samuelwilliams413/METR4810/Software/Demo75_with_interupts/Demo75/keys.pdf

q | Winch up a | Winch down w | Servo 1 + 10° s | Servo 1 - 10° e | Servo 2 + 10° d | Servo 2 - 10° i | Car forward k | Stop car l | Turn right j | Turn left m | Reverse

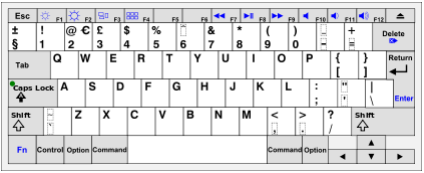
[picture p1: figure]
