samuelwilliams413/METR4810/Software/keys.pdf

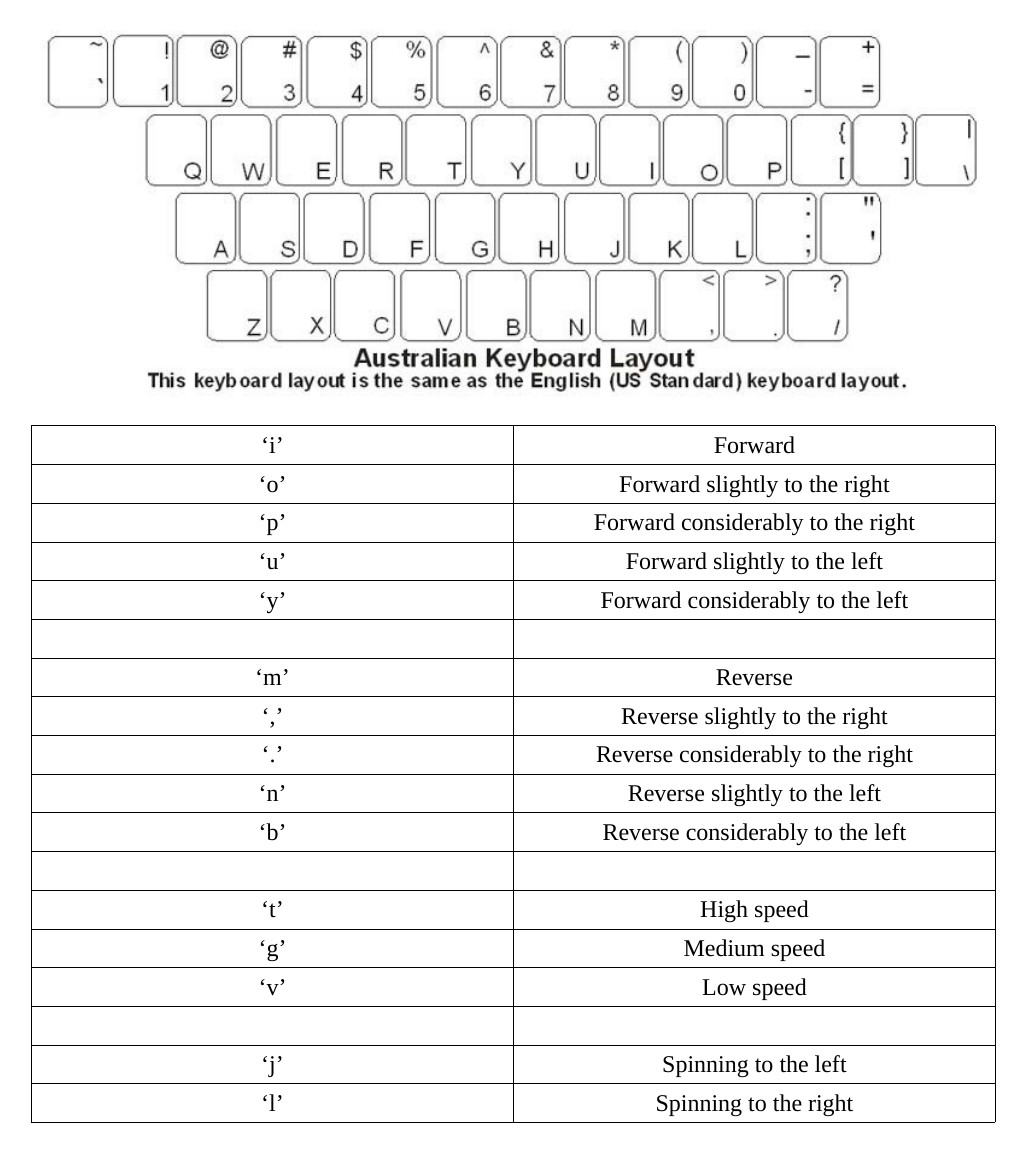
[picture p2: figure]

K stop
