samuelwilliams413/METR4810/Bill of Materials/Sam_BOM_Part List.xlsx

Sheet: Sheet1
Component Names | Description | Part Number | Quantity Used | Supplier | Unit Cost (ex GST) | Preowned | Datasheet Provided | Cost | Sum Total
Central Controller PCB |  |  |  |  |  |  |  | 15.5629 | 37.70757333
Atmega324 | Atmega324 | Atmega324-AU-1322 | 1 | Mouser | 4.06 | Yes | Yes | 4.06 | https://www.digikey.com/product-detail/en/microchip-technology/ATMEGA324P-20AUR/ATMEGA324P-20AURCT-ND/3440935
10K Ohm Resistor | 10K Ohm Resistor |  | 1 | Digikey | 0.00148 | No | Yes | 0.00148 | https://www.digikey.com/product-detail/en/yageo/RC0402JR-0710KP/YAG1281TR-ND/4935296
1K Ohm Resistor | 1K Ohm Resistor |  | 9 | Digikey | 0.00106 | No | Yes | 0.00954 | https://www.digikey.com/product-detail/en/yageo/RC0402JR-071KL/311-1.0KJRTR-ND/726408
1uF Capacitor | 1uF Capacitor |  | 4 | Jameco | 0.023 | No | Yes | 0.092 | http://www.jameco.com/z/12063G105ZAT2A-AVX-Capacitor-1-uF-25-Volt-Y5-Volt-20-To-80-Surface-Mount-1206-Embossed-Tape-and-Reel_740324.html
100pF Capacitor | 100pF Capacitor |  | 5 | Jameco | 0.005 | No | Yes | 0.025 | http://www.jameco.com/z/GRM1885C1H101JA01J-Murata-Capacitor-100pf-50-Volt-C0G-5-Surface-Mount-0603-Paper-Tape-and-Reel_1856644.html
L7805CD2T Volateg Regulator | Positive voltage regulator IC | L7805CD2T | 1 | Mouser | 0.321 | No | Yes | 0.321 | http://au.mouser.com/ProductDetail/STMicroelectronics/L7805CD2T-TR/
L293D Motor Driver | Push-pull four channel driver with diodes | L293D | 1 | Digikey | 2.84 | Yes | Yes | 2.84 | https://www.digikey.com.au/product-detail/en/stmicroelectronics/L293D/497-2936-5-ND/634700
16 Pin Socket | 16 Pin Socket |  | 1 | Jameco | 0.39 | Yes | No | 0.39 | http://www.jameco.com/z/6100-16-R-Socket-IC-16-Pin-Machine-Tooled-Low-Profile-0-3-Inch-Wide_37402.html
2 Pin Header | KK Style - Straight Header Male |  | 2 | Element14 | 0.113 | No | Yes | 0.226 | http://au.element14.com/molex/22-27-2021/header-square-pin-2-54mm-2way/dp/9731148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
2 Pin Header | KK Style - Straight Header Female |  | 2 | Element14 | 0.031 | No | Yes | 0.062 | http://au.element14.com/molex/22-01-3027/housing-square-pin-2-54mm-2way/dp/1462825?ost=22-01-3027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
3 Pin Header | KK Style - Straight Header Male |  | 3 | Element14 | 0.296 | No | Yes | 0.888 | http://au.element14.com/molex/22-27-2031/header-square-pin-2-54mm-3way/dp/9731156
3 Pin Header | KK Style - Straight Header Female |  | 3 | Element14 | 0.099 | No | Yes | 0.297 | http://au.element14.com/molex/22-01-3037/housing-female-3way/dp/1462838?ost=22-01-3037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
4 Pin Header | KK Style - Straight Header Male |  | 4 | Element14 | 0.408 | No | Yes | 1.632 | http://au.element14.com/molex/22-27-2041/header-square-pin-2-54mm-4way/dp/9731164?ost=22-27-2041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
4 Pin Header | KK Style - Straight Header Female |  | 4 | Element14 | 0.139 | No | Yes | 0.556 | http://au.element14.com/molex/22-01-3047/housing-female-4way/dp/1462831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
Crimp | KK Style Crimp |  | 29 | Element14 | 0.027 | No | Yes | 0.783 | http://au.element14.com/molex/08-50-0113/contact-crimp-terminal-30-22awg/dp/2063734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
2x3 Pin Header | 6 Way 2 Row Header |  | 1 | modDIY | $0.59 | No | Yes | 0.59 | https://www.moddiy.com/products/0.100%22-%282.54-mm%29-Breakaway-Male-Header%3A-2x40%252dPin%2C-Straight.html
DB15 Female Header | DB15 Female Header |  | 1 | Digikey | 0.81788 | No | No | 0.81788 | https://www.digikey.com/product-detail/en/amphenol-fci/10090926-P154XLF/609-4022-ND/2350294
Diode | 0603 Series Blue LED | 697-3617 | 4 | RS | $0.24 | No | Yes | 0.972 | http://au.rs-online.com/web/p/visible-leds/6973617/?searchTerm=697-3617
PCB | 55mm x 60mm x 1.6mm 2 layer PCB |  | 1 | PCBway | 1 | No | No | 1
Distribution PCB |  |  |  |  |  |  |  | 6.83306
1K Ohm Resistor | 1K Ohm Resistor |  | 3 | Digikey | 0.00106 | No | Yes | 0.00318 | https://www.digikey.com/product-detail/en/yageo/RC0402JR-071KL/311-1.0KJRTR-ND/726408
1uF Capacitor | 1uF Capacitor |  | 2 | Jameco | 0.023 | No | Yes | 0.046 | http://www.jameco.com/z/12063G105ZAT2A-AVX-Capacitor-1-uF-25-Volt-Y5-Volt-20-To-80-Surface-Mount-1206-Embossed-Tape-and-Reel_740324.html
100pF Capacitor | 100pF Capacitor |  | 4 | Jameco | 0.005 | No | Yes | 0.02 | http://www.jameco.com/z/GRM1885C1H101JA01J-Murata-Capacitor-100pf-50-Volt-C0G-5-Surface-Mount-0603-Paper-Tape-and-Reel_1856644.html
3 Pin Header | KK Style - Straight Header Male |  | 3 | Element14 | 0.296 | No | Yes | 0.888 | http://au.element14.com/molex/22-27-2031/header-square-pin-2-54mm-3way/dp/9731156
3 Pin Header | KK Style - Straight Header Female |  | 3 | Element14 | 0.099 | No | Yes | 0.297 | http://au.element14.com/molex/22-01-3037/housing-female-3way/dp/1462838?ost=22-01-3037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
4 Pin Header | KK Style - Straight Header Male |  | 5 | Element14 | 0.408 | No | Yes | 2.04 | http://au.element14.com/molex/22-27-2041/header-square-pin-2-54mm-4way/dp/9731164?ost=22-27-2041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
4 Pin Header | KK Style - Straight Header Female |  | 5 | Element14 | 0.139 | No | Yes | 0.695 | http://au.element14.com/molex/22-01-3047/housing-female-4way/dp/1462831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
Crimp | KK Style Crimp |  | 29 | Element14 | 0.027 | No | Yes | 0.783 | http://au.element14.com/molex/08-50-0113/contact-crimp-terminal-30-22awg/dp/2063734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
DB15 Female Header | DB15 Female Header |  | 1 | Digikey | 0.81788 | No | No | 0.81788 | https://www.digikey.com/product-detail/en/amphenol-fci/10090926-P154XLF/609-4022-ND/2350294
Diode | 0603 Series Blue LED | 697-3617 | 1 | RS | $0.24 | No | Yes | 0.243 | http://au.rs-online.com/web/p/visible-leds/6973617/?searchTerm=697-3617
PCB | 38mm x 45mm x 1.6mm 2 layer PCB |  | 1 | PCBway | 1 | No | No | 1
Miscellaneous |  |  |  |  |  |  |  | 7.97828
15 Core Unscreened PVC Cable | 15 Core Unscreened PVC Cable |  | 2 | RS | 2.372 | No | Yes | 4.744 | http://au.rs-online.com/web/p/multicore-industrial-cable/6603999/
Motor Driver |  |  | 1 |  |  | Yes | Yes | 0
Buck |  |  | 1 |  |  | No | Yes | 0
HC-05 |  |  | 1 |  |  | No | Yes | 0
Rocker Switch, Non Illuminated | Rocker Switch, Non Illuminated | A8L-11-15N1 | 1 |  | 1.52 | No | Yes | 1.52 | http://au.element14.com/omron-electronic-components/a8l-11-15n1/switch-rocker-spst-mini/dp/1829494?mckv=s|pcrid|59148083448&gross_price=true&CATCI=aud-112905144048:pla-173777534688&CAAGID=12550800888&CMP=KNC-GOO-SHOPPING-1829494&CAGPSPN=pla&gclid=CMW-5P6GkdQCFUd9vQodM9wPcA&CAWELAID=120185580000129312
Battery Pack |  |  |  |  |  | No | No | 0
DB15 Male Header | DB15 Male Header |  | 2 | Digikey | 0.51214 | No | Yes | 1.02428 | https://www.digikey.com/product-detail/en/amphenol-fci/10090769-P154ALF/609-4042-ND/2350290
DB15 Backshell | DB15 Backshell |  | 2 | Digikey | 0.345 | No | Yes | 0.69 | https://www.digikey.com/product-detail/en/cinch-connectivity-solutions-aim-cambridge/40-9709H/367-1139-ND/3830261
Buoy |  |  |  |  |  |  |  | 7.333333333
Bolts |  |  |  |  |  |  |  | 0
Nuts |  |  |  |  |  |  |  | 0
EVA Foam Tiles | EVA Foam Tiles |  | 0.4 | Kmart | 10 | No | No | 4 | http://www.kmart.com.au/product/eva-solid-floor-tiles/764887
25m PVC Pipe |  |  |  |  |  |  |  | 0
25m PVC Pipe Elbow Connector |  |  |  |  |  |  |  | 0
Food Containers | Food Containers |  | 2 | Woolworths | 1.666666667 | Yes | No | 3.333333333
Spiral Binding |  |  |  |  |  |  |  | 0
25 mm Saddles

Sheet: Sheet2
10K Ohm Resistor | 10K Ohm Resistor |  | 1 | 4 | ETSG
1K Ohm Resistor | 1K Ohm Resistor |  | 12 | 48 | ETSG
1uF Capacitor | 1uF Capacitor |  | 6 | 24 | ETSG
100pF Capacitor | 100pF Capacitor |  | 9 | 36 | ETSG
16 Pin Socket | 16 Pin Socket |  | 1 | 4 | ETSG
2 Pin Header | KK Style - Straight Header |  | 2 | 8 | ETSG
3 Pin Header | KK Style - Straight Header |  | 6 | 24 | ETSG
4 Pin Header | KK Style - Straight Header |  | 9 | 36 | ETSG
2x3 Pin Header | 6 Way 2 Row Header |  | 1 | 4 | ETSG
Atmega324 | Atmega324 | Atmega324-AU-1322 | 1 | 4 | RS
L7805C2T Volateg Regulator | Positive voltage regulator IC | L7805C2T | 1 | 4 | RS
L293D Motor Driver | Push-pull four channel driver with diodes | L293D | 1 | 4 | RS
DB15 Female Header | DB15 Female Header |  | 2 | 8 | RS
Diode | 0603 Series Blue LED | 697-3617 | 5 | 20 | RS
DB15 Cable MM |  |  | 1 | 4 | RS
Motor Driver |  |  | 1 | 4 | RS
Buck |  |  | 1 | 4 | RS
HC-05 |  |  | 1 | 4 | RS
