samuelwilliams413/METR4810/Bill of Materials/BillOfMaterialsMcKay.xlsx

Bill Of Materials
Item | Qty | Price /unit | Total Cost | Purchase Location
12V Micro Gear Motor | 4 | 3.59 (5% discount) | 0 | http://www.ebay.com.au/itm/DC-12V-100RPM-Gearbox-Mini-Metal-Gear-geared-Motor-Gearwheel-N20-Shaft-Dia-3mm-/391722197482
Micro Metal Gear Motor Mounts | 0 | 3.87 | 0 | https://www.pololu.com/product/989
65mm Off Road Tires | 1 | 6.9 | 6.9 | http://www.kmart.com.au/webapp/wcs/stores/servlet/ProductDisplay?urlRequestType=Base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
Aluminium Sheet | 33000 | 6.655902778e-05 | 2.196447917 | http://earlybirdsteel.com.au/aluminium/aluminium-sheet
3D Printed Pieces | 4 | 0 | 0
Romak Hexagon Nuts | 0 | 0.135 | 0 | Romak hexagon nuts M3 24 pack
Romak M3 Bolts | 0 | 0.165 | 0 | Romak M3x15mm bolts 20 pack
L298N Motor Drivers | 3 | 1.87 | 5.61 | http://www.ebay.com/itm/Stepper-Motor-Drive-Controller-Board-Module-L298N-Dual-H-Bridge-DC-For-Arduino-M-/172390155575
Eiger 40Lumen Torches | 0 | 3.666666667 | 0
Waterproof LED strip | 6 | 0.0824 | 0.4944 | http://www.ebay.com.au/itm/24-48-96-120-LED-Car-Flexible-Linear-Strip-Light-Fish-Tank-Aquarium-Waterproof-/302250643921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
 |  |  |  | http://www.ebay.com/itm/DC12V-16ft-1-5M-5630-waterproof-300-LED-Light-Strip-Flexible-Ribbon-3M-Tape-lamp-/262373742486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
3mm Hex Wheel Adaptor | 2 | 2.99 | 5.98
12V 9.8kg/cm torque micro motors | 4 | 8.86 | 35.44 | http://www.ebay.com/itm/1Pcs-DC6V-12V-N20-Micro-Gear-Motor-Gear-Ratio-1-1000-High-Torque-10-15-20-30rpm-/172438281294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
30A VNH2SP30 motor driver | 1 | 7.29 | 0 | http://www.ebay.com/itm/1pcs-Dual-VNH2SP30-Stepper-Motor-Driver-Module-Monster-Moto-Shield-Replace-L298N-/201414927724
12V 25D 300 oz-in motor | 4 | 9 | 0 | http://www.ebay.com/itm/1PCS-DC12V-80RPM-CNDF-Gear-Box-Motor-with-Diameter-25mm-Metal-Gear-Reduction-Box-/172461801138
2800mAh LiPo Battery | 1 | 0 | 0 | http://www.ebay.com/itm/XT60-Discharger-Plug-VOK-3S-Lipo-Battery-11-1V-2800mAh-25C-For-RC-Quad-Airplane/302172602515
Running Total |  |  | 56.62084792
 |  | 12V 1000:1 motor |  | http://www.ebay.com/itm/1Pcs-DC6V-12V-N20-Micro-Gear-Motor-Gear-Ratio-1-1000-High-Torque-10-15-20-30rpm-/172438281294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
