samuelwilliams413/METR4810/Bill of Materials/Budget final.xlsx

 | Final budget
 | Part | Description | units | unit price | price
Mechanical | Alluminium:
 | Sheet |  | 33000 | 1 | 2.19
 | Rod |  |  | 1
 | Wood
 | Bolts | M3 romak | 20 |  | 3.3
 | Nuts | romak hexagon | 20 |  | 2.7
 | Glands |  | 3
 | Conduit pipe |  | 1.515151515 | 1.48 | 2.265151515 | https://www.bunnings.com.au/deta-20mm-medium-duty-rigid-cond
 | Manipulator |  | 1 | 5.95 AUD |  | http://www.ebay.com.au/itm/Manipulator-Alloy-Paw-Arm-Mechanical-Robotic-Claw-Clamp-for-Arduino-Robot-MG995-/252857056617
 | DC motor |  | 4 | 8.86 | 35.44
 | Servo |  | 1
 | Foam
 | Containers
 | Stepper |  | 1
 | Brackets |  | 2
Electrical | Hbridge | 293D | 1 | 0.6 | 0.6
 | Voltage reg. |  | 2
 | Through hole socket |  | 1
 | Resistors:
 | 1K Ohm
 | 10k Ohm
 | LED
 | LED
 | Torch |  | 3 |  | 5
 | VHS-USB adaptor |  | 1 | 10.92 | 10.92 | http://www.ebay.com.au/itm/142170948081?_trksid=p2057872.m2749.l2649&ssPageName=STRK%3AMEBIDX%3AIT
 | Camera Set |  | 1 | 10.77 | 10.77 | http://www.ebay.com.au/itm/222438363376?_trksid=p2057872.m2749.l2649&ssPageName=STRK%3AMEBIDX%3AIT
 | Atmega324a |  | 1
 | Capacitors |  | 2
 | 100uf
 | 1uF
 | Headers:
 | 2x1
 | 4x1
 | 3x2
 | 4x2
 | 6x2
 | DB15 Female Header |  | 1
 | DB15 Cable |  | 2m
 | DB15 Female Header |  | 1
 | Turnigy 6V battery |  | 2 | 13.53 | 27.06 | https://hobbyking.com/en_us/turnigy-receiver-pack-sub-c-4200mah-6-0v-nimh-high-power-series.html
 | Motor Shield |  |  | 2.51 | 2.51 | http://www.ebay.com/itm/Stepper-Motor-Drive-Controller-Board-Module-L298N-Dual-H-Bridge-DC-For-Arduino-M-/172390155575
 | PCB
 |  |  |  |  | 102.7551515
