samuelwilliams413/METR4810/Mechanical/ClawDesign/FirstClaw/Design/dfxFiles/servoPipeConnection.dxf

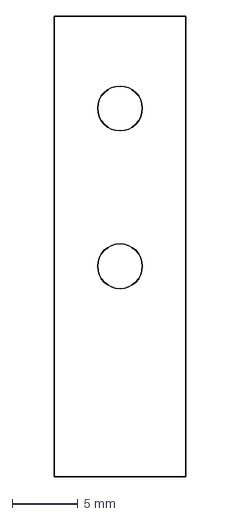
[picture p3: CAD file, 2017-04-24]
Mechanical/ClawDesign/FirstClaw/Design/dfxFiles/servoPipeConnection.dxf
10.0 x 35.0 mm
