samuelwilliams413/METR4810/Mechanical/ClawDesign/FirstClaw/Design/PartsFromLibraries/Hinge/PINO SUS-304.stp

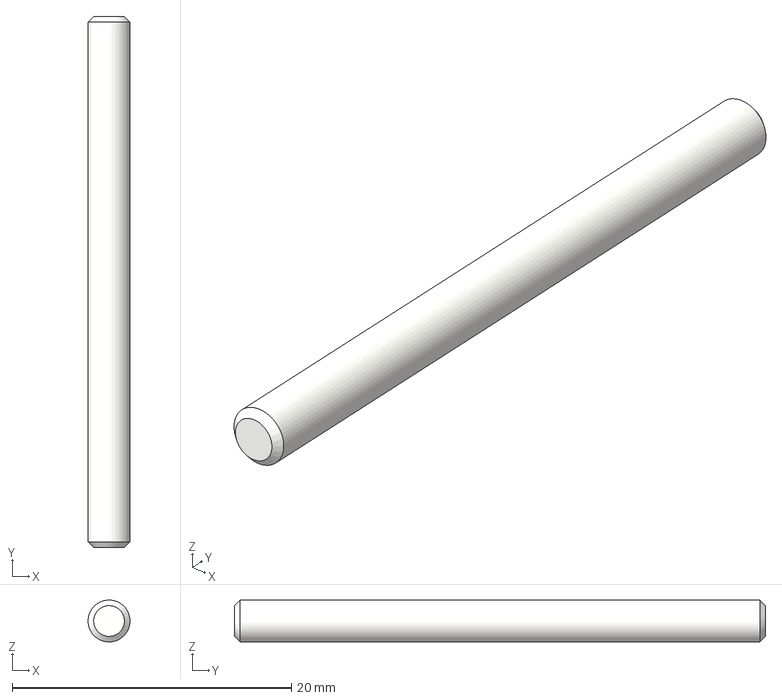
[picture p4: CAD file, 2017-04-24]
Mechanical/ClawDesign/FirstClaw/Design/PartsFromLibraries/Hinge/PINO SUS-304.stp
3.00 x 38.0 x 3.00 mm
