samuelwilliams413/METR4810/Mechanical/ClawDesign/FirstClaw/Design/PartsFromLibraries/MG995/TOWER PRO MG-995, ANALOG SERVO.STEP

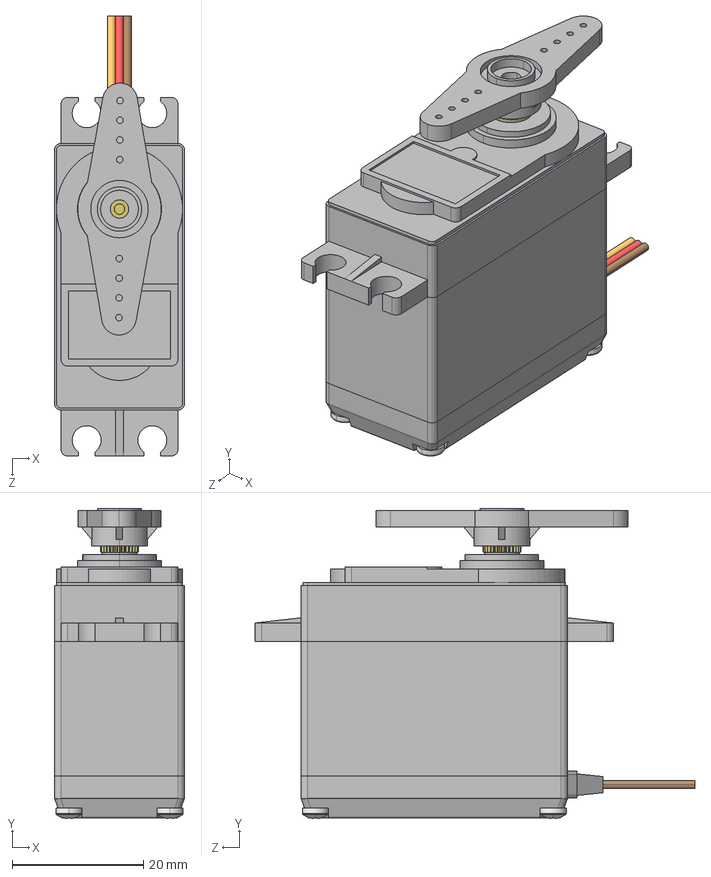
[picture p5: CAD file, 2017-04-24]
Mechanical/ClawDesign/FirstClaw/Design/PartsFromLibraries/MG995/TOWER PRO MG-995, ANALOG SERVO.STEP
19.8 x 47.2 x 67.0 mm
TOWER PRO MG-995, ANALOG SERVO, BODY, BOTTOM
TOWER PRO MG-995, ANALOG SERVO, BODY, MIDDLE
TOWER PRO MG-995, ANALOG SERVO, BODY, TOP
TOWER PRO MG-995, ANALOG SERVO, CONNECTOR
TOWER PRO MG-995, ANALOG SERVO, SHAFT
TOWER PRO MG-995, ANALOG SERVO, HORN
pan cross head_am_B18.6.7M - M2 x 0.4 x 10 Type I Cross Recessed PHMS --10N x 4
