samuelwilliams413/METR4810/Mechanical/ClawDesign/FirstClaw/Design/StepFiles/CLAW.stp

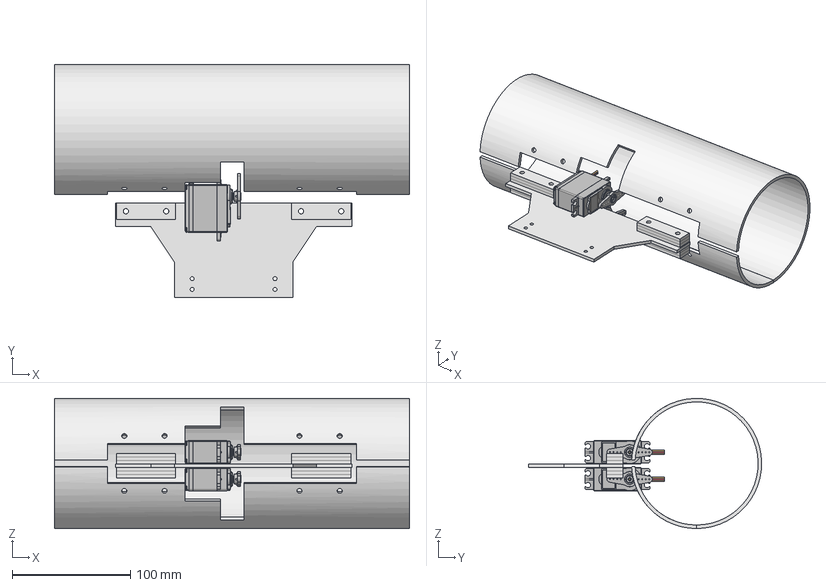
[picture p6: CAD file, 2017-04-24]
Mechanical/ClawDesign/FirstClaw/Design/StepFiles/CLAW.stp
300.0 x 197.1 x 109.9 mm
adjustmentHingePlate x 12
plate
TOWER PRO MG-995, ANALOG SERVO, BODY, BOTTOM x 2
TOWER PRO MG-995, ANALOG SERVO, BODY, MIDDLE x 2
TOWER PRO MG-995, ANALOG SERVO, BODY, TOP x 2
TOWER PRO MG-995, ANALOG SERVO, CONNECTOR x 2
TOWER PRO MG-995, ANALOG SERVO, SHAFT x 2
TOWER PRO MG-995, ANALOG SERVO, HORN x 2
pan cross head_am_B18.6.7M - M2 x 0.4 x 10 Type I Cross Recessed PHMS --10N x 8
lowerClaw
upperClaw
