samuelwilliams413/METR4810/Mechanical/ClawDesign/SecondClaw/Design/Parts/gearfinger2.stl

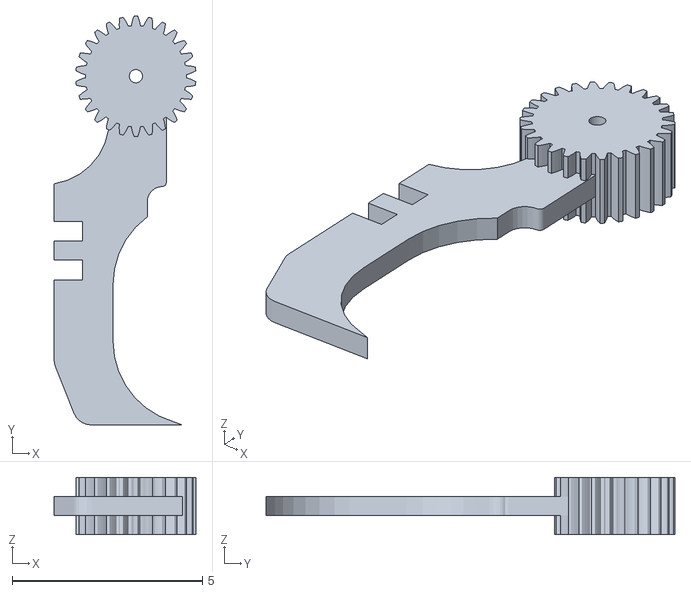
[picture p7: CAD file, 2017-05-25]
Mechanical/ClawDesign/SecondClaw/Design/Parts/gearfinger2.stl
3.73 x 10.8 x 1.50
