samuelwilliams413/METR4810/Mechanical/ClawDesign/SecondClaw/Design/STLfiles/CenterFinger.stl

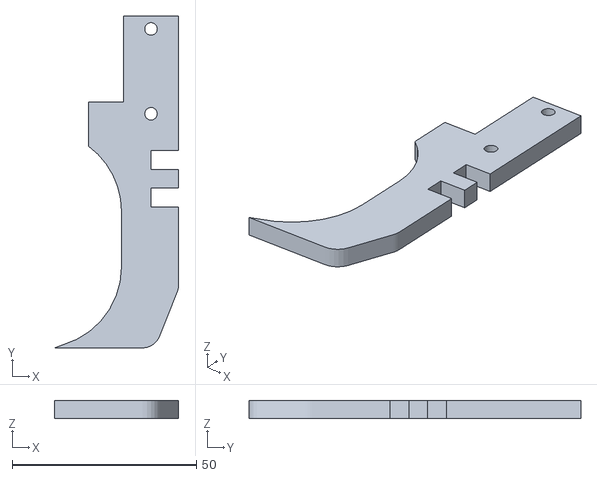
[picture p8: CAD file, 2017-05-14]
Mechanical/ClawDesign/SecondClaw/Design/STLfiles/CenterFinger.stl
33.7 x 90.0 x 5.00
