samuelwilliams413/METR4810/Mechanical/ClawDesign/SecondClaw/PrototypeMckay/FingerBrace-5.2.SLDPRT

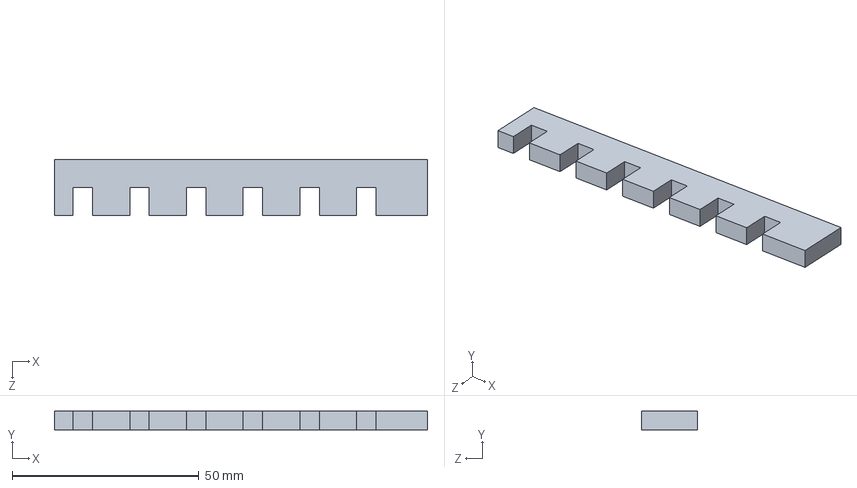
[picture p9: CAD file, 2017-05-14]
Mechanical/ClawDesign/SecondClaw/PrototypeMckay/FingerBrace-5.2.SLDPRT
100.0 x 5.00 x 15.0 mm
