samuelwilliams413/METR4810/Mechanical/metr4810_spool draft/metr4810_spool draft/PARTS/toPrint/Spool_end_piece.stl

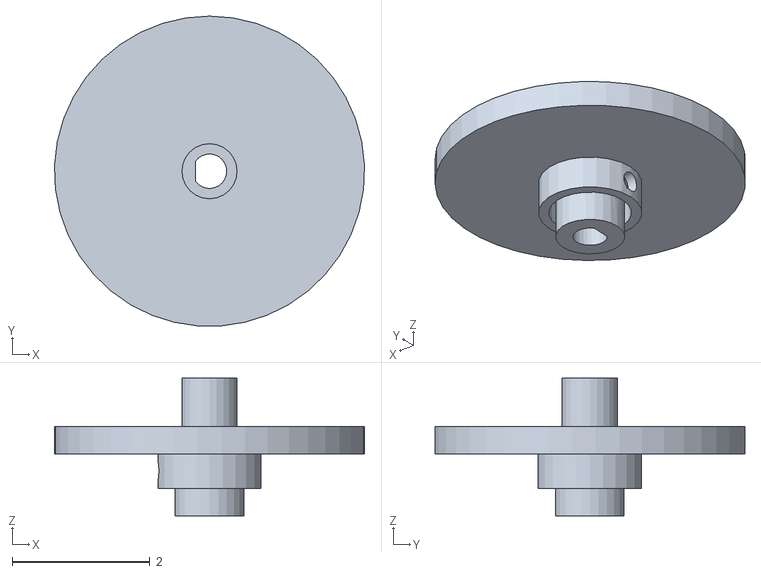
[picture p10: CAD file, 2017-05-10]
Mechanical/metr4810_spool draft/metr4810_spool draft/PARTS/toPrint/Spool_end_piece.stl
4.50 x 4.49 x 2.00
