samuelwilliams413/METR4810/Submission/Mechanical/Claw/STL/shortBrace.stl

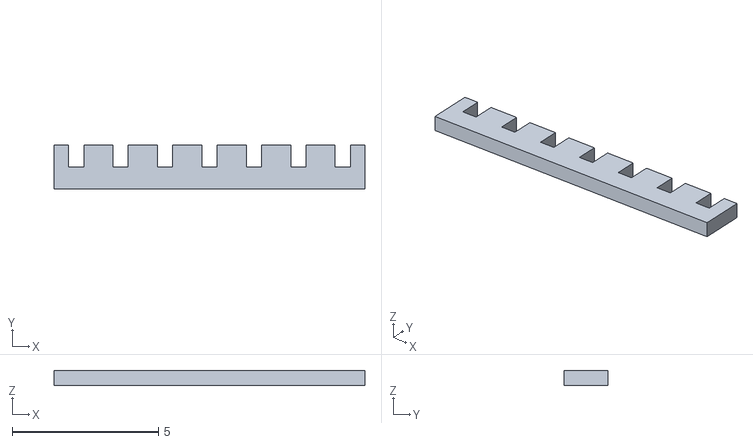
[picture p11: CAD file, 2017-05-27]
Submission/Mechanical/Claw/STL/shortBrace.stl
10.6 x 1.50 x 0.5
