samuelwilliams413/METR4810/Mechanical/ClawDesign/FirstClaw/Design/dfxFiles/plate.dxf

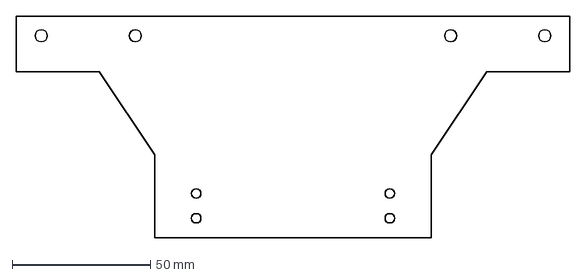
[picture p12: CAD file, 2017-04-24]
Mechanical/ClawDesign/FirstClaw/Design/dfxFiles/plate.dxf
200.0 x 80.0 mm
