samuelwilliams413/METR4810/Mechanical/ClawDesign/FirstClaw/Design/PartsFromLibraries/Hinge/HINGE SUS-304.stp

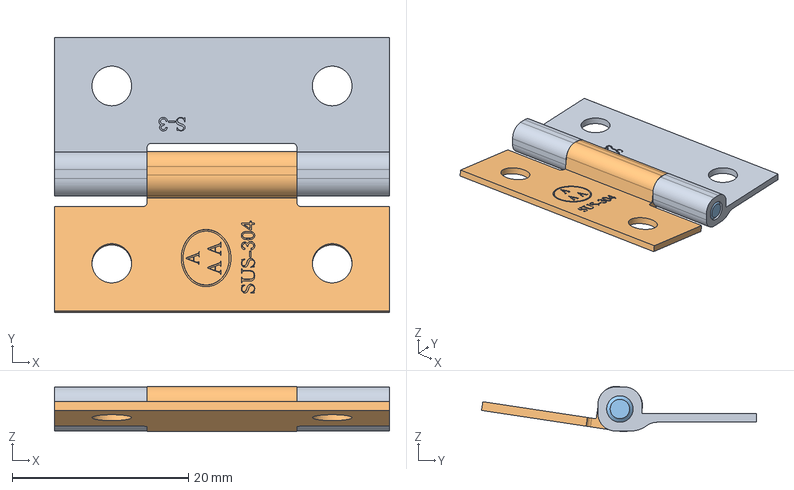
[picture p13: CAD file, 2017-04-24]
Mechanical/ClawDesign/FirstClaw/Design/PartsFromLibraries/Hinge/HINGE SUS-304.stp
38.0 x 31.2 x 5.14 mm
ABA 01
ABA 02
PINO SUS-304
