samuelwilliams413/METR4810/Mechanical/ClawDesign/SecondClaw/PrototypeMckay/ClawFingerTrial-5.2.SLDPRT

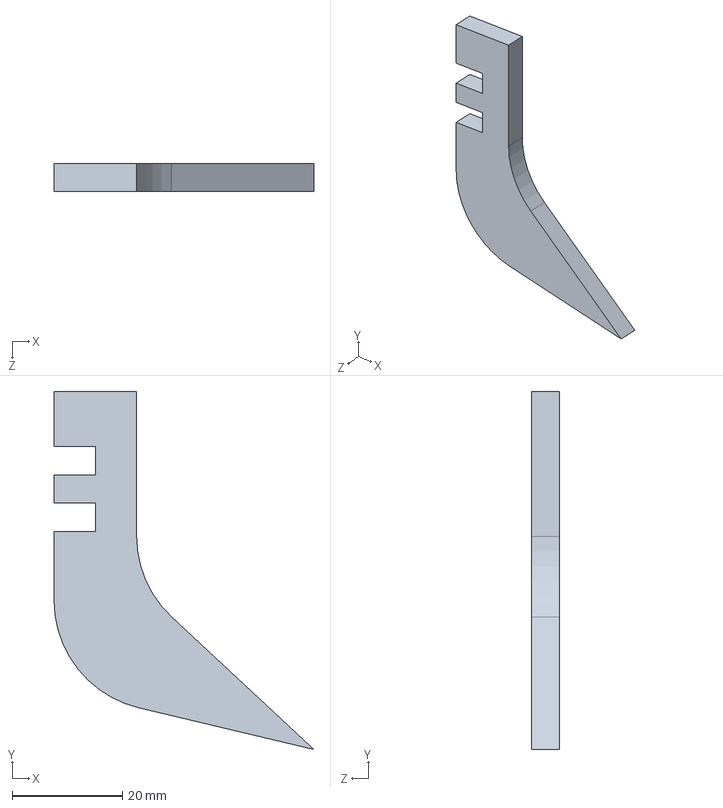
[picture p14: CAD file, 2017-05-14]
Mechanical/ClawDesign/SecondClaw/PrototypeMckay/ClawFingerTrial-5.2.SLDPRT
47.2 x 65.0 x 5.00 mm
