samuelwilliams413/METR4810/Submission/Mechanical/Claw/STL/brace.stl

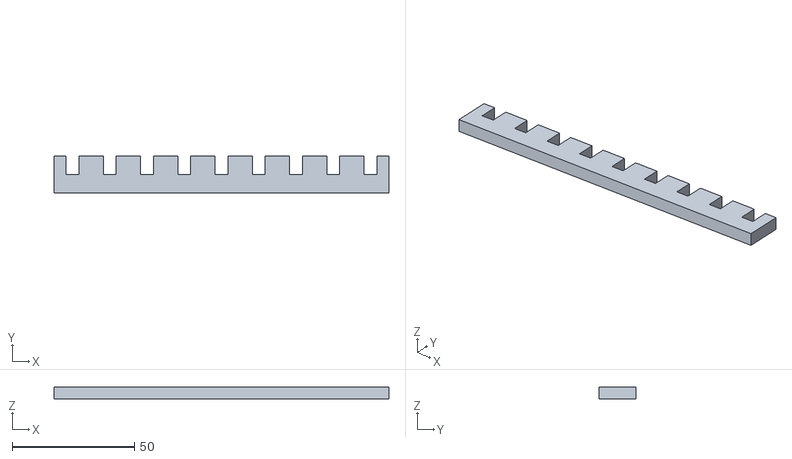
[picture p15: CAD file, 2017-05-21]
Submission/Mechanical/Claw/STL/brace.stl
136.8 x 15.0 x 5.00
