samuelwilliams413/METR4810/Mechanical/ClawDesign/FirstClaw/Design/dfxFiles/pipeServo.dxf

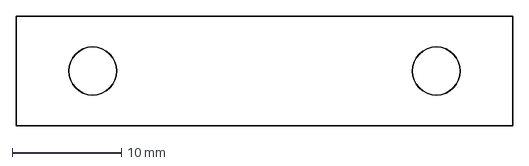
[picture p16: CAD file, 2017-04-24]
Mechanical/ClawDesign/FirstClaw/Design/dfxFiles/pipeServo.dxf
45.5 x 10.0 mm
