samuelwilliams413/METR4810/Submission/Mechanical/Claw/STL/Finger.stl

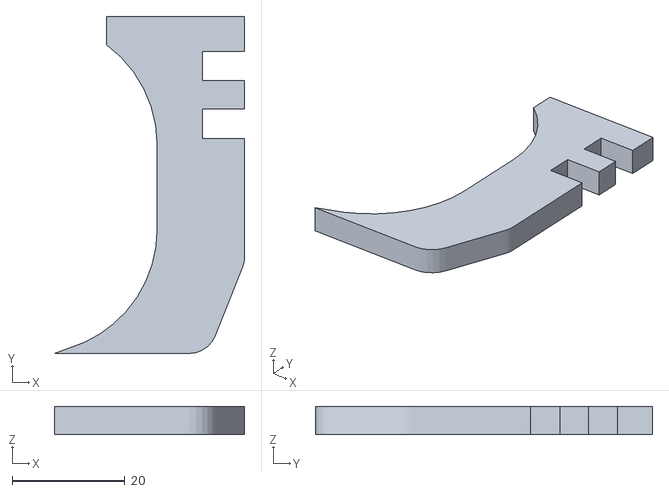
[picture p18: CAD file, 2017-05-14]
Submission/Mechanical/Claw/STL/Finger.stl
33.7 x 59.7 x 5.00
