samuelwilliams413/METR4810/Mechanical/ClawDesign/FirstClaw/Design/dfxFiles/adjustmentHingePlate.dxf

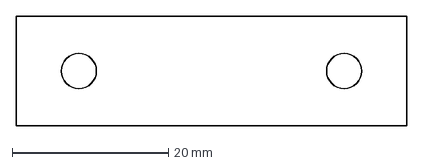
[picture p19: CAD file, 2017-04-24]
Mechanical/ClawDesign/FirstClaw/Design/dfxFiles/adjustmentHingePlate.dxf
50.0 x 14.0 mm
