samuelwilliams413/METR4810/Mechanical/ClawDesign/FirstClaw/Design/PartsFromLibraries/Hinge/ABA 02.stp

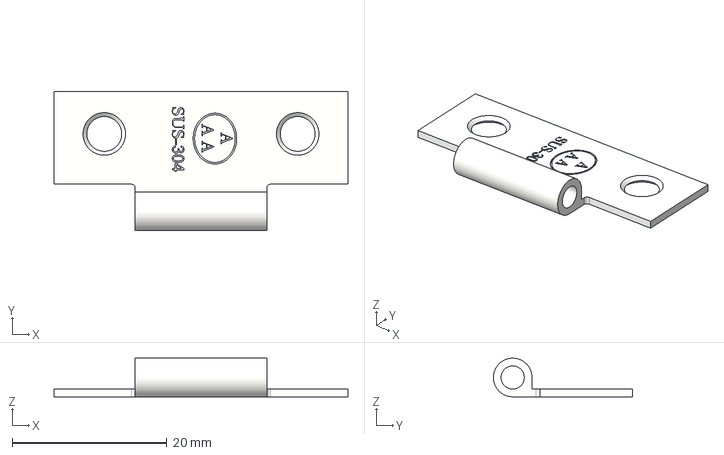
[picture p20: CAD file, 2017-04-24]
Mechanical/ClawDesign/FirstClaw/Design/PartsFromLibraries/Hinge/ABA 02.stp
38.0 x 18.0 x 5.00 mm
