samuelwilliams413/METR4810/Mechanical/ClawDesign/FirstClaw/Design/dfxFiles/arm.dxf

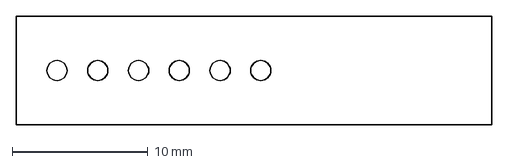
[picture p21: CAD file, 2017-04-24]
Mechanical/ClawDesign/FirstClaw/Design/dfxFiles/arm.dxf
35.0 x 8.00 mm
