samuelwilliams413/METR4810/Mechanical/ClawDesign/FirstClaw/Design/PartsFromLibraries/Hinge/SierraPacific-BH7015ZN.SLDPRT

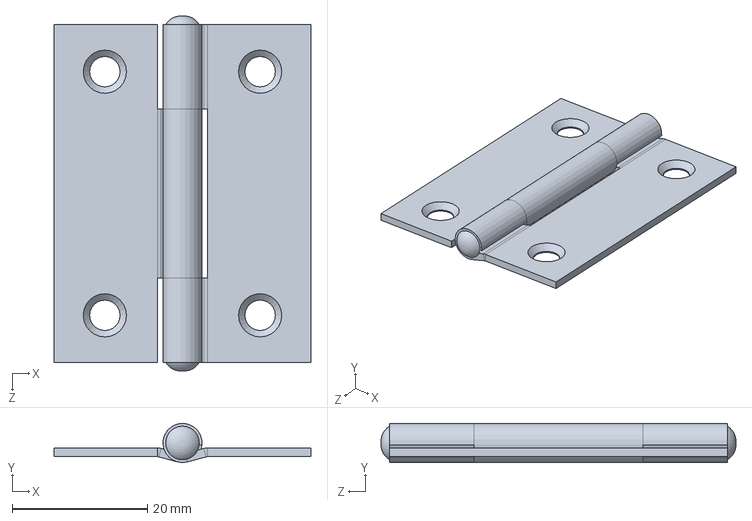
[picture p22: CAD file, 2017-04-24]
Mechanical/ClawDesign/FirstClaw/Design/PartsFromLibraries/Hinge/SierraPacific-BH7015ZN.SLDPRT
38.0 x 5.79 x 52.6 mm
