samuelwilliams413/METR4810/(list of files, cad)

Other CAD files:
Mechanical/ClawDesign/FirstClaw/Design/dwg_2D/lowerClaw.dwg
Mechanical/ClawDesign/ThirdClaw/Design/dwg/brace.dwg
Submission/Mechanical/Buoy/DWG/stepperMount.dwg
Submission/Mechanical/Claw/DWG/Spur Gear21.dwg
Mechanical/ClawDesign/FirstClaw/Design/dwg_2D/pipeServo.dwg
Mechanical/ClawDesign/ThirdClaw/Design/dwg/CenterFinger.dwg
Submission/Mechanical/Buoy/DWG/endPlate-1.dwg
Mechanical/ClawDesign/FirstClaw/Design/dwg_2D/plate.dwg
Mechanical/ClawDesign/ThirdClaw/Design/dwg/Finger.dwg
Submission/Mechanical/Buoy/DWG/Bearing mount.dwg
Mechanical/ClawDesign/FirstClaw/Design/dwg_2D/upperClaw.dwg
Mechanical/ClawDesign/FirstClaw/Design/dwg_2D/adjustmentHingePlate.dwg
Mechanical/ClawDesign/FirstClaw/Design/dwg_2D/servoPipeConnection.dwg
Mechanical/ClawDesign/FirstClaw/Design/dwg_2D/arm.dwg
Mechanical/ClawDesign/FirstClaw/Design/Assembly/CLAW.iam
Mechanical/ClawDesign/FirstClaw/Design/Assembly/PlateWithHinges.iam
Mechanical/ClawDesign/FirstClaw/Design/OldVersions/adjustmentHingePlate.0001.dwg
Mechanical/ClawDesign/FirstClaw/Design/OldVersions/adjustmentHingePlate.0001.ipt
Mechanical/ClawDesign/FirstClaw/Design/OldVersions/adjustmentHingePlate.0001_1.dwg
Mechanical/ClawDesign/FirstClaw/Design/OldVersions/adjustmentHingePlate.0004.ipt
Mechanical/ClawDesign/FirstClaw/Design/OldVersions/arm.0001.dwg
Mechanical/ClawDesign/FirstClaw/Design/OldVersions/lowerClaw.0001.dwg
Mechanical/ClawDesign/FirstClaw/Design/OldVersions/lowerClaw.0001_1.dwg
Mechanical/ClawDesign/FirstClaw/Design/OldVersions/lowerClaw.0005.ipt
Mechanical/ClawDesign/FirstClaw/Design/OldVersions/pipeServo.0001.dwg
Mechanical/ClawDesign/FirstClaw/Design/OldVersions/plate.0001.dwg
Mechanical/ClawDesign/FirstClaw/Design/OldVersions/plate.0002.ipt
Mechanical/ClawDesign/FirstClaw/Design/OldVersions/servoPipeConnection.0001.dwg
Mechanical/ClawDesign/FirstClaw/Design/OldVersions/servoPipeConnection.0001_1.dwg
Mechanical/ClawDesign/FirstClaw/Design/OldVersions/servoPipeConnection.0002.dwg
Mechanical/ClawDesign/FirstClaw/Design/OldVersions/servoPipeConnection.0002.ipt
Mechanical/ClawDesign/FirstClaw/Design/OldVersions/upperClaw.0001.dwg
Mechanical/ClawDesign/FirstClaw/Design/OldVersions/upperClaw.0001_1.dwg
Mechanical/ClawDesign/FirstClaw/Design/OldVersions/upperClaw.0004.ipt
Mechanical/ClawDesign/FirstClaw/Design/Parts/adjustmentHingePlate.ipt
Mechanical/ClawDesign/FirstClaw/Design/Parts/arm.ipt
Mechanical/ClawDesign/FirstClaw/Design/Parts/lowerClaw.ipt
Mechanical/ClawDesign/FirstClaw/Design/Parts/pipeServo.ipt
Mechanical/ClawDesign/FirstClaw/Design/Parts/plate.ipt
Mechanical/ClawDesign/FirstClaw/Design/Parts/servoPipeConnection.ipt
Mechanical/ClawDesign/FirstClaw/Design/Parts/servoPlateConnection.ipt
Mechanical/ClawDesign/FirstClaw/Design/Parts/upperClaw.ipt
Mechanical/ClawDesign/FirstClaw/Design/PartsFromLibraries/Hinge/ABA 01.ipt
Mechanical/ClawDesign/FirstClaw/Design/PartsFromLibraries/Hinge/HINGE SUS-304.ipt
Mechanical/ClawDesign/FirstClaw/Design/PartsFromLibraries/Hinge/SierraPacific-BH7015ZN.ipt
Mechanical/ClawDesign/FirstClaw/Design/PartsFromLibraries/MG995/TOWER PRO MG-995, ANALOG SERVO, BODY, BOTTOM.ipt
Mechanical/ClawDesign/FirstClaw/Design/PartsFromLibraries/MG995/TOWER PRO MG-995, ANALOG SERVO, BODY, MIDDLE.ipt
Mechanical/ClawDesign/FirstClaw/Design/PartsFromLibraries/MG995/TOWER PRO MG-995, ANALOG SERVO, BODY, TOP.ipt
Mechanical/ClawDesign/FirstClaw/Design/PartsFromLibraries/MG995/TOWER PRO MG-995, ANALOG SERVO, CONNECTOR.ipt
Mechanical/ClawDesign/FirstClaw/Design/PartsFromLibraries/MG995/TOWER PRO MG-995, ANALOG SERVO, HORN.ipt
Mechanical/ClawDesign/FirstClaw/Design/PartsFromLibraries/MG995/TOWER PRO MG-995, ANALOG SERVO, SHAFT.ipt
Mechanical/ClawDesign/FirstClaw/Design/PartsFromLibraries/MG995/TOWER PRO MG-995, ANALOG SERVO.iam
Mechanical/ClawDesign/FirstClaw/Design/PartsFromLibraries/MG995/pan cross head_am_B18.6.7M - M2 x 0.4 x 10 Type I Cross Recessed PHMS --10N.ipt
Mechanical/ClawDesign/SecondClaw/Design/Assembly/Assembly.iam
Mechanical/ClawDesign/SecondClaw/Design/OldVersions/CenterFinger.0003.ipt
Mechanical/ClawDesign/SecondClaw/Design/OldVersions/Finger.0003.ipt
Mechanical/ClawDesign/SecondClaw/Design/OldVersions/Finger2.0004.ipt
Mechanical/ClawDesign/SecondClaw/Design/OldVersions/brace.0001.ipt
Mechanical/ClawDesign/SecondClaw/Design/Parts/CenterFinger.ipt
Mechanical/ClawDesign/SecondClaw/Design/Parts/Finger.ipt
Mechanical/ClawDesign/SecondClaw/Design/Parts/Finger_MIR.ipt
Mechanical/ClawDesign/SecondClaw/Design/Parts/Finger_MIR1.ipt
Mechanical/ClawDesign/SecondClaw/Design/Parts/Finger_MIR1_MIR.ipt
Mechanical/ClawDesign/SecondClaw/Design/Parts/brace.ipt
Mechanical/ClawDesign/SecondClaw/Design/Parts/gearfinger1.ipt
Mechanical/ClawDesign/SecondClaw/Design/Parts/gearfinger2.iam
Mechanical/ClawDesign/SecondClaw/Design/STLfiles/Finger.stl
Mechanical/ClawDesign/SecondClaw/Design/STLfiles/brace.stl
Mechanical/ClawDesign/SecondClaw/PrototypeMckay/ClawFingerTrial-5.2.STL
Mechanical/ClawDesign/SecondClaw/PrototypeMckay/FingerBrace-5.2.STL
Mechanical/ClawDesign/ThirdClaw/Design/OldVersions/brace.0001.ipt
Mechanical/ClawDesign/ThirdClaw/Design/Parts/CenterFinger.ipt
Mechanical/ClawDesign/ThirdClaw/Design/Parts/Finger.ipt
Mechanical/ClawDesign/ThirdClaw/Design/Parts/OldVersions/CenterFinger.0005.ipt
Mechanical/ClawDesign/ThirdClaw/Design/Parts/OldVersions/Finger.0006.ipt
Mechanical/ClawDesign/ThirdClaw/Design/Parts/brace.ipt
Mechanical/ClawDesign/ThirdClaw/Design/dwg/OldVersions/brace.0001.dwg
Submission/Mechanical/Buoy/Parts/bearing support.ipt
Submission/Mechanical/Buoy/Parts/endPlate.ipt
Submission/Mechanical/Buoy/Parts/stepperMount.ipt
Submission/Mechanical/Claw/DWG/Finger.dwg
Submission/Mechanical/Claw/DWG/OldVersions/Finger.0001.dwg
Submission/Mechanical/Claw/DWG/OldVersions/brace.0001.dwg
Submission/Mechanical/Claw/DWG/brace.dwg
Submission/Mechanical/Claw/DWG/shortBrace.dwg
Submission/Mechanical/Claw/Parts/Finger.ipt
Submission/Mechanical/Claw/Parts/OldVersions/shortBrace.0003.ipt
Submission/Mechanical/Claw/Parts/Spur Gear21.ipt
Submission/Mechanical/Claw/Parts/brace.ipt
Submission/Mechanical/Claw/Parts/shortBrace.ipt
Submission/Mechanical/Rover/Parts/Mount.SLDDRW
Submission/Mechanical/Rover/Parts/NewBody.SLDDRW
