samuelwilliams413/METR4810/Submission/UserManual/UserManual.pdf

# The Goldfish User Manual

### METR4810 Team 10

### May 29, 2017

1

## Warning!

The Goldfish was designed and build only to recover the submarine. The user assumes the responsibility of using it for any other purpose!

## Contents

1 Introduction | 4
2 System description | 4
3 Assembly | 5
4 Required software | 6
5 Starting the Goldfish | 7
6 System control | 8

## 1 Introduction

The Goldfish is used to recover the sunken miniature submarine from the tank. This user manual describes how to assemble the Goldfish and how to successfully use it to accomplish the recovery mission. The manual contains also hints about the required software.

Figure 1: The Goldfish.


## 2 System description

The Goldfish consists of a buoy floating on the sea surface and a rover equipped with a camera and a claw. The Goldfish is controlled using a computer keyboard. Table 1 gives the complete list of parts that compose the Goldfish.

Table 1: List of parts composing the Goldfish.

Part | Quantity
Claw with arm | 1
Claw fingers | 11
Claw short finger | 1
Rover body | 1
Rover wheels | 4
DB cable | 1
Camera receiver | 1
Buoy arm | 4
Buoy foam | 4
Buoy electronic container | 1
Winch container | 1

## 3 Assembly

In order to assemble the Goldfish you will need the following tools:

- Screw drive
- Wrench

Follow the steps below to assemble the Goldfish:

- Attach the servo container at the bottom of the electronic container making sure that the stepper wire are going through the holes to the PCB in the electronic container.
- Connect each one of the arms to one side on the bottom of the winch container.
- Attach the servo arm to the rover body using M4 bolts and nuts.
- Mount the wheels to the rover DC motors.
- Build the two side of the claw using the fingers as shown in figure. Attach each side the one of the claw sides. Make sure that the short finger is on the section containing the servo and that the short brace from the servo side.

Figure 2: Goldfish claw.


## 4 Required software

### 4.1 Bluetooth communication

The Goldfish is remotely controlled through bluetooth serial communication. After establishing the bluetooth connection with the Goldfish, you have several ways to communicate with the system. One possibility is to use the open source software PUTTY. PUTTY is an SSH and telnet client. To download and install PUTTY, use the following link. Select your platform and follow the instructions: https://www.chiark.greenend.org.uk/~sgtatham/putty/latest.html. (https://www.chiark.greenend.org.uk/~sgtatham/putty/latest.html)

### 4.2 Camera software

To run the Goldfish camera, you will need to download and install the open source software XSplit broadcaster using the following link: https://www.xsplit.com/#broadcaster

## 5 Starting the Goldfish

To start the Goldfish, press the Start Button on the buoy.

### 5.1 Starting the camera

The camera receiver has to be connected to one of the computer USB ports. Then start XSplit. Once the XSplit is opened follow these steps:

- Click source in the menu bar.
- Select Webcame,capture card, video devices.
- Click AV TO USB2.0.

At that moment you should see the streaming from the camera. However the image is flipped. To correct it:

- Go to Scene at the bottom of the XSplit window.
- Select AV TO USB2.0.
- Click Settings on the bottom left of the XSplit window.
- Select the tab Layout and the press flip horizontally.

### 5.2 Establishing the bluetooth connection

Establishing the Bluetooth models depends on the used platform, please refer to your platform bluetooth documentation. Here is a description for Windows users. Once the Goldfish is powered, in the computer under the Bluetooth properties, select ”Add a device”. The default device name of the Bluetooth module is ”Goldfish”. Double click ”Goldfish” and select the ”Hardware” tab, you can see which COM port the module is connected.

### 5.3 Using serial communication

As stated above, you may use any terminal programs for the serial communication. Here are the instruction for using PUTTY.

- Select the Serial radio button.

- Type the COM port number that the Bluetooth device is connecting to.
- Set the default baud rate to 9600.
- Click ”Open”. A terminal should be opened. The first line should contain the ”Ready!” message which indicates that the Bad Bit is ready for receiving commands.

## 6 System control

The Goldfish is controlled through the keyboard. Table 2 summarizes the keys that control the Goldfish. After pressing a key, it is not required to press the enter key. Once the command has been executed, a feedback message is displayed in the terminal followed by the current status of all actuators.

Table 2: Keys controlling the system.

Character | Action
’q’ | Move the winch rope up
’a’ | Move the winch rope down
’x’ | Hold the winch
’z’ | Release the winch
’w’ | Move the claw servo 5◦ toward closing
’s’ | Move the claw servo 5◦ toward opening
’e’ | Move the camera servo 5◦ to the left
’r’ | Move the camera servo 5◦ to the right
’i’ | Move the rover forward
’m’ | Move the rover backward
’k’ or space | Stop the rover
’l’ | Turn the rover to the right
’j’ | Turn the rover to the left
