samuelwilliams413/METR4810/Submission/UserManual/20170529_053608.jpg

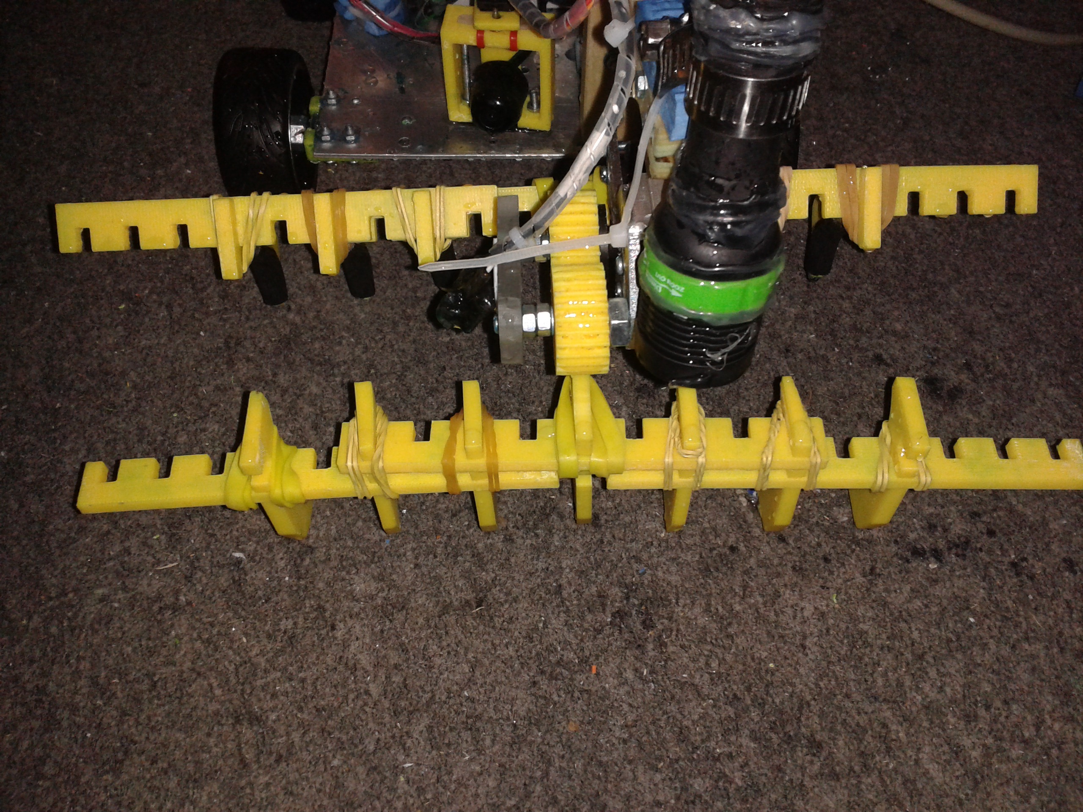
Submission/UserManual/20170529_053608.jpg
