samuelwilliams413/METR4810/Submission/UserManual/20170529_053620.jpg

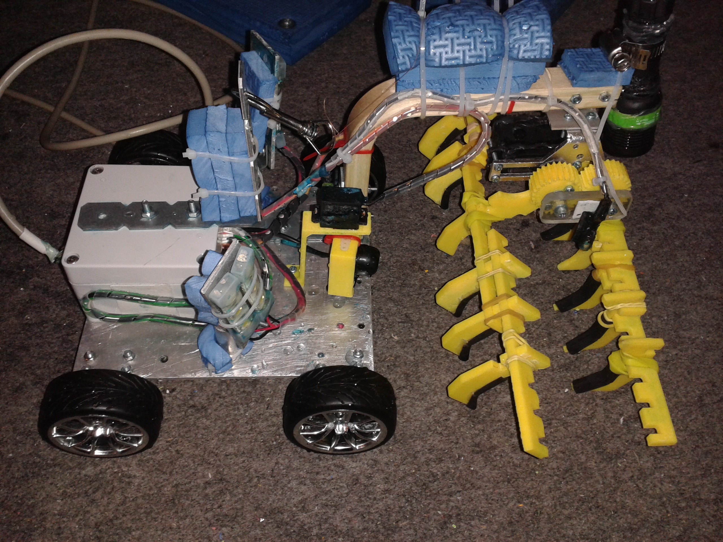
Submission/UserManual/20170529_053620.jpg
