samuelwilliams413/METR4810/Electrical/PCB_Central_Controller/PCB_METR4810/METR4810_Schematic.pdf

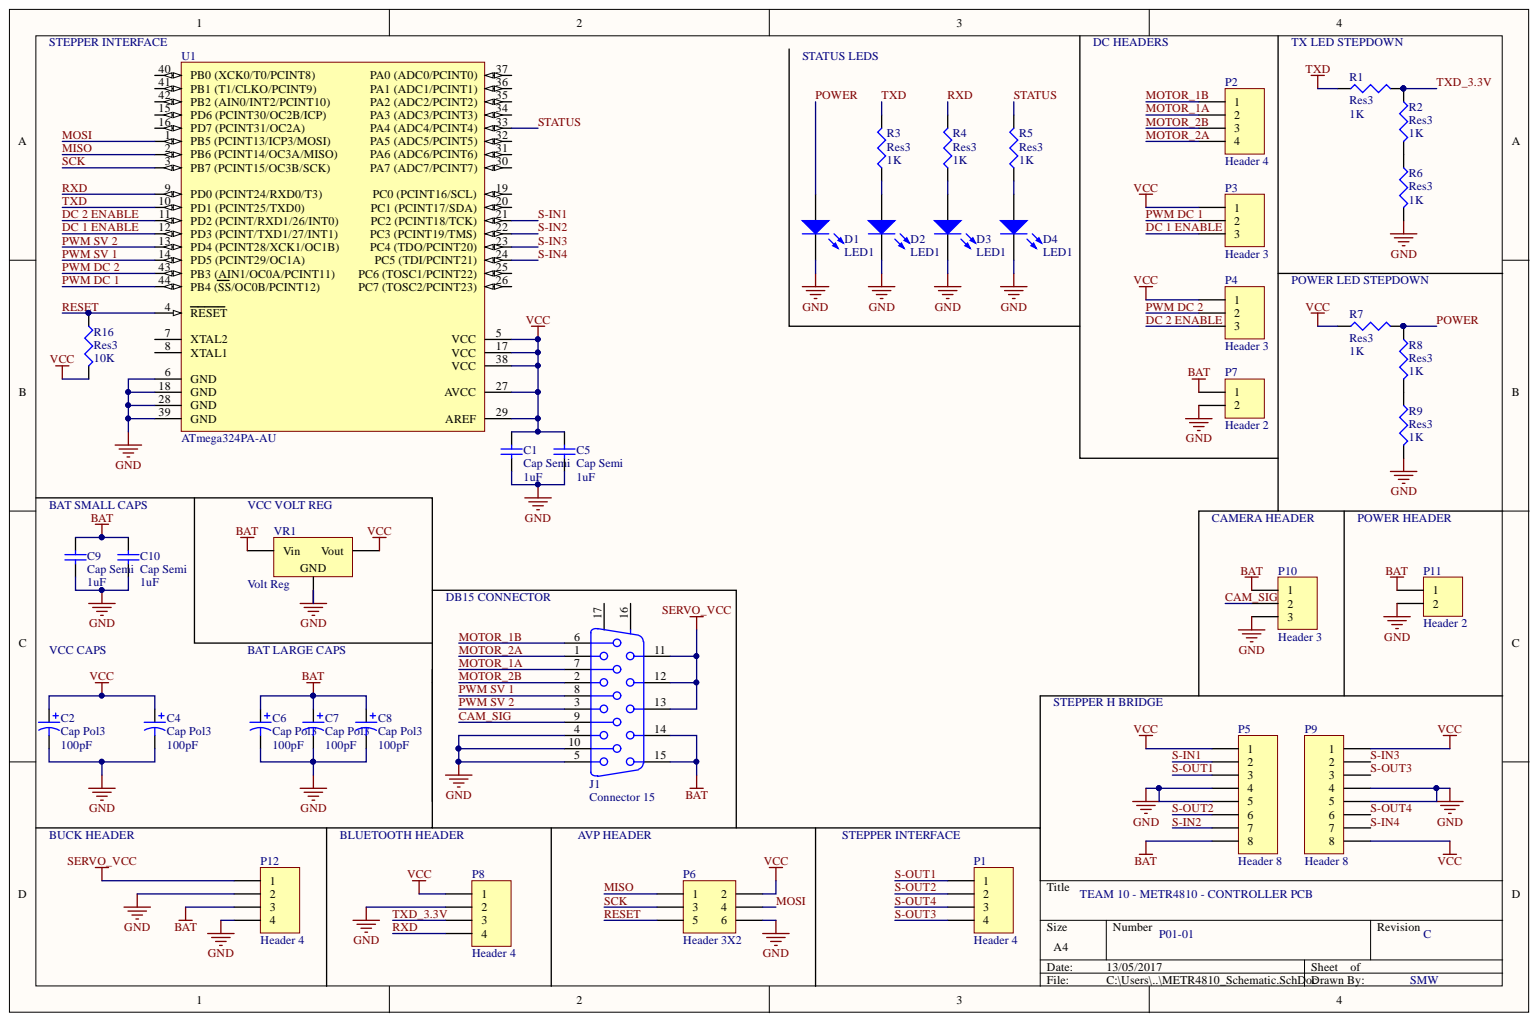
[picture p28: page 1]

PWM DC 1 DC 1 ENABL

1 7
3 8
