samuelwilliams413/METR4810/Submission/Mechanical/Buoy/PDF/Bearing mount.pdf

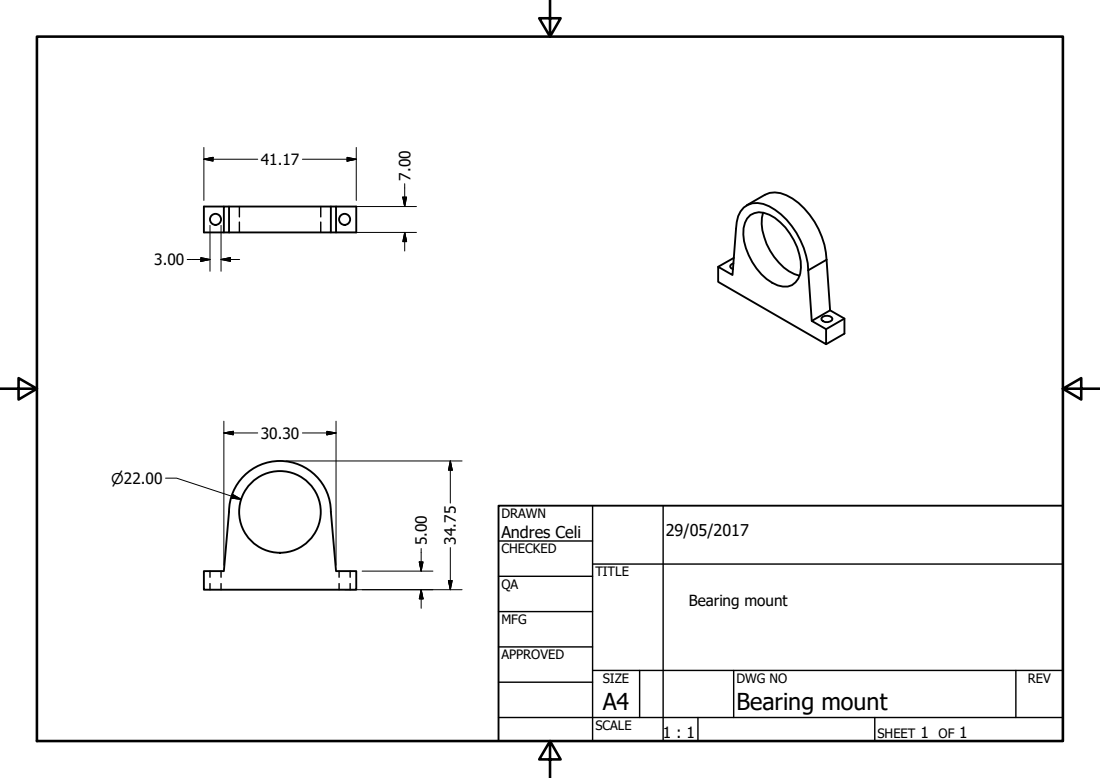
[picture p29: page 1]
SHEET 1 OF 1; DRAWN; CHECKED; MFG; APPROVED; Andres Celi; DWG NO Bearing mount; TITLE; SIZE A4; SCALE; REV; Bearing mount
