samuelwilliams413/METR4810/Submission/Mechanical/Buoy/PDF/endPlate-1.pdf

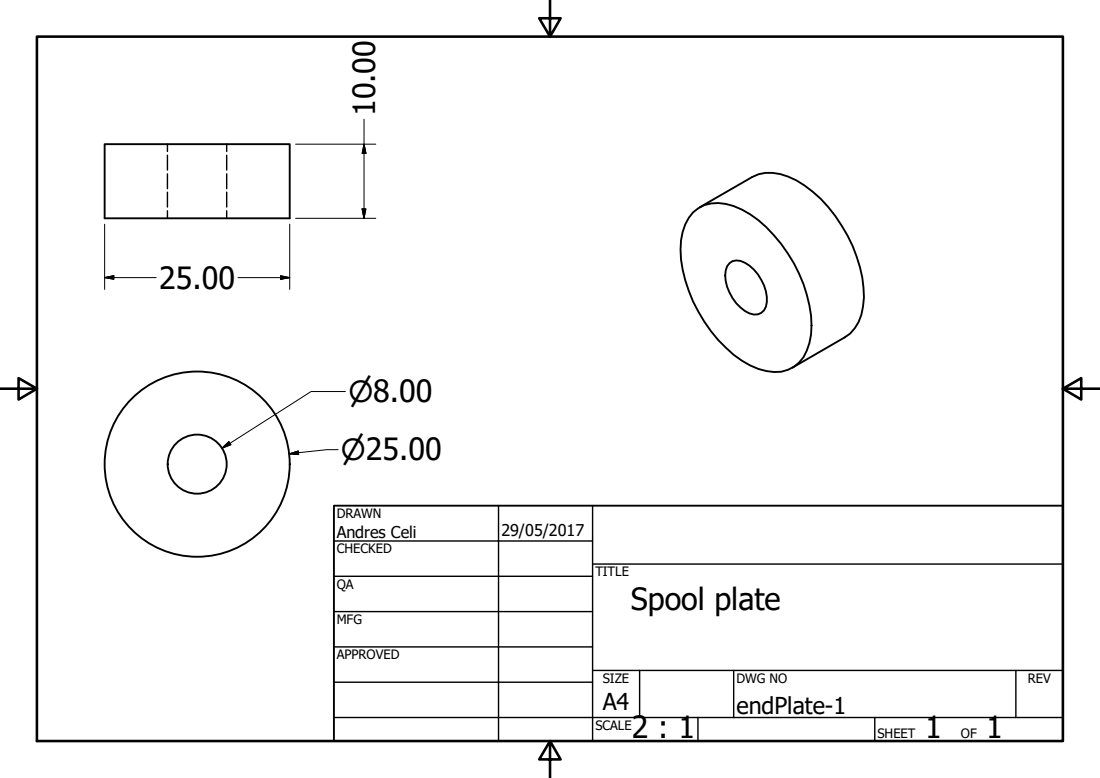
[picture p30: page 1]
SHEET 1 OF 1; DRAWN; CHECKED; MFG; APPROVED; Andres Celi; DWG NO endPlate-1; TITLE; SIZE A4; SCALE; REV; Spool plate
