samuelwilliams413/METR4810/Submission/Mechanical/Buoy/PDF/stepperMount.pdf

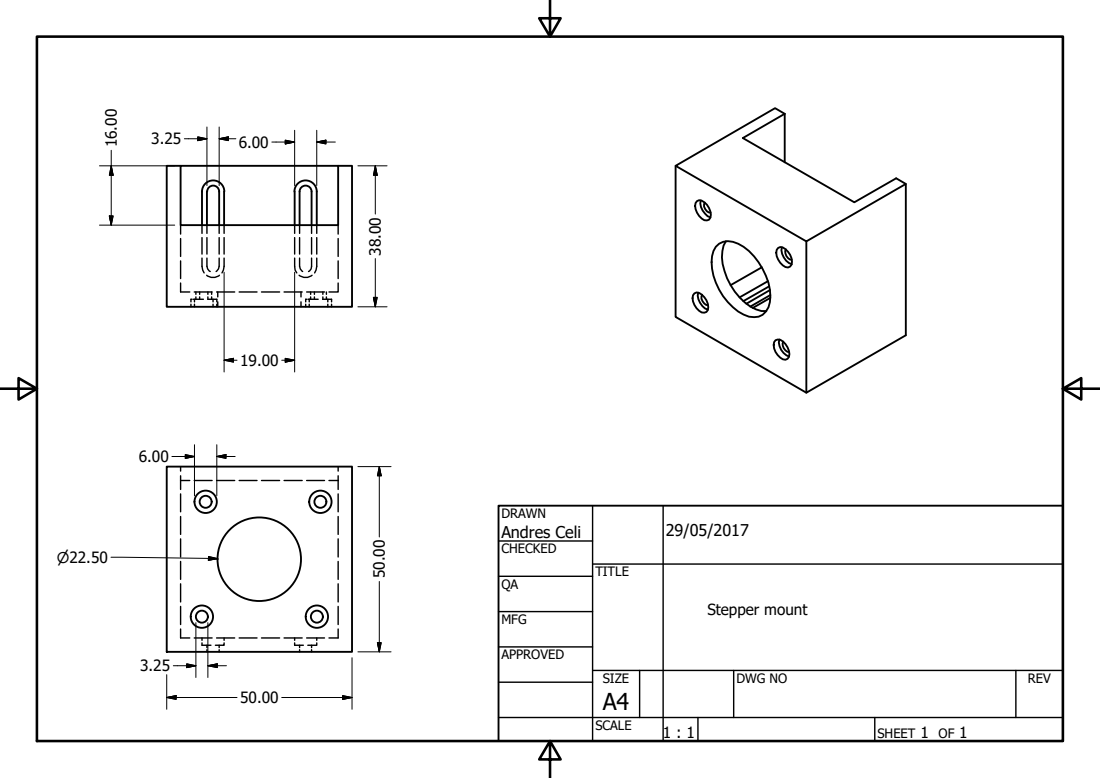
[picture p31: page 1]
SHEET 1 OF 1; DRAWN; CHECKED; MFG; APPROVED; Andres Celi; DWG NO; TITLE; SIZE A4; SCALE; REV; Stepper mount
