samuelwilliams413/METR4810/Submission/Mechanical/Claw/PDF/Claw middle blade.pdf

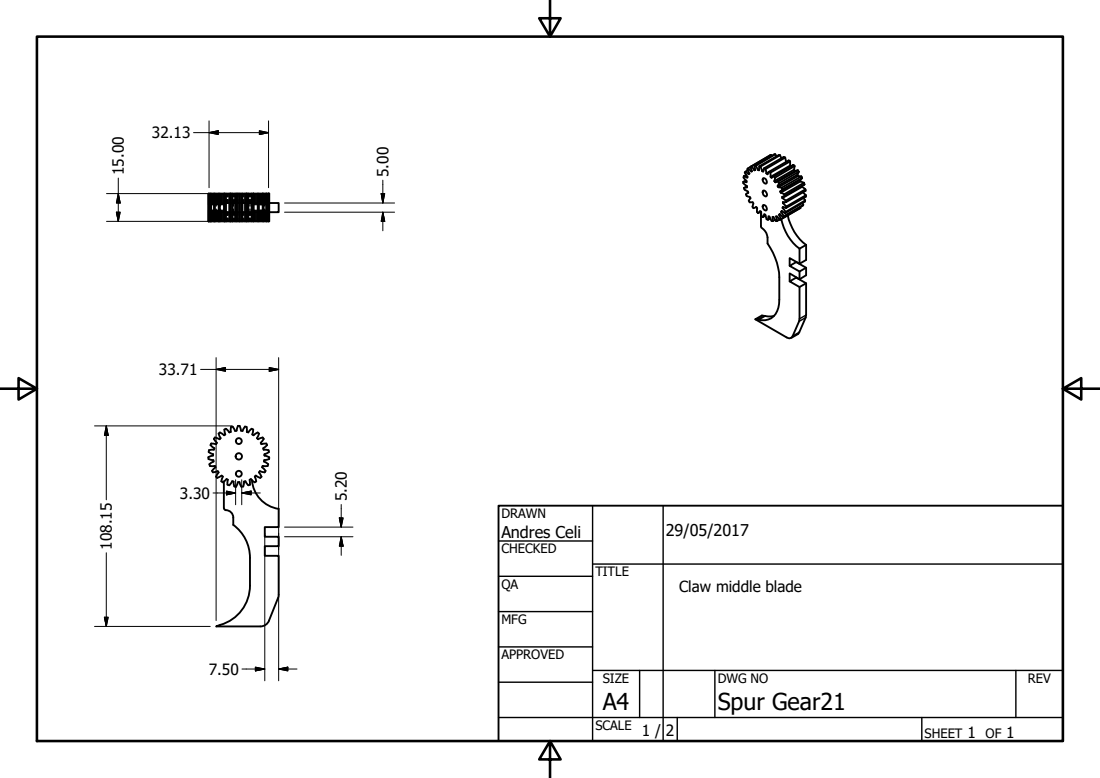
[picture p32: page 1]
SHEET 1 OF 1; DRAWN; CHECKED; MFG; APPROVED; Andres Celi; DWG NO Spur Gear21; TITLE; SIZE A4; SCALE; REV

Claw middle blade
