samuelwilliams413/METR4810/Submission/Mechanical/Rover/PDF/Mount.PDF

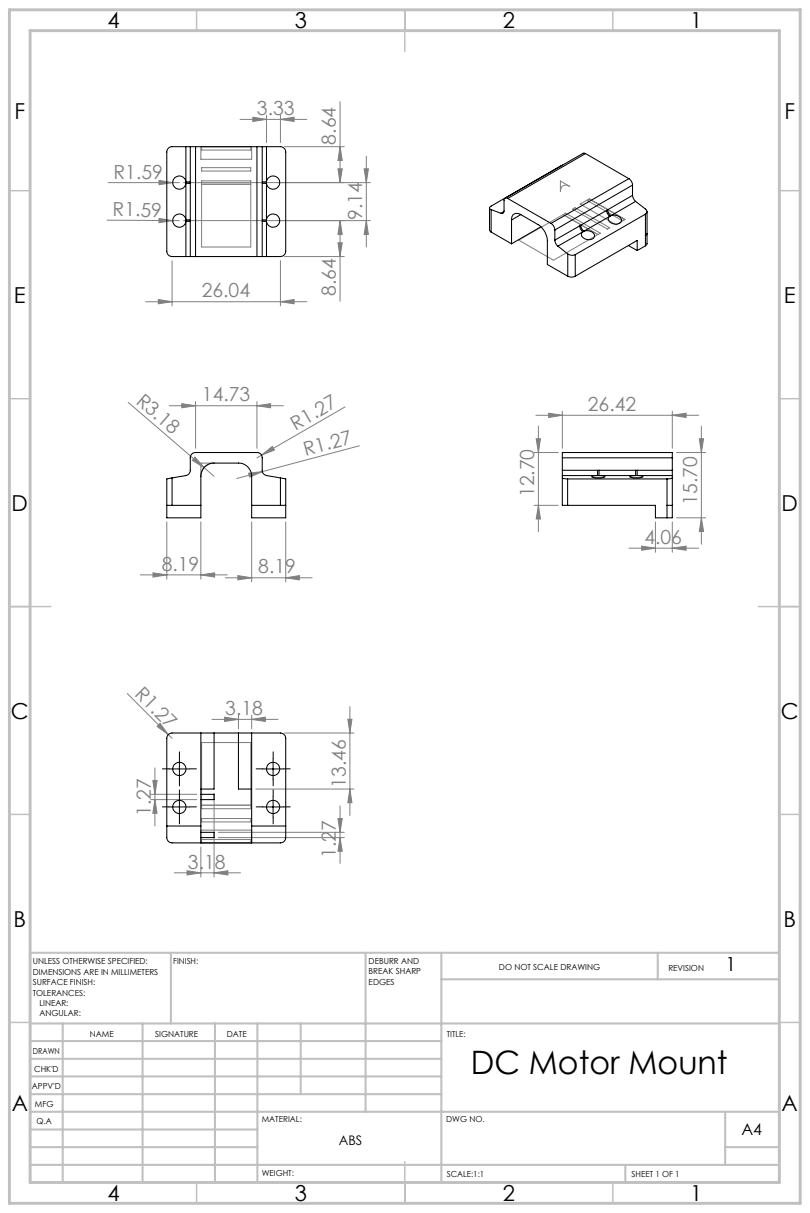
[picture p33: page 1]
FINISH:; DEBURR AND; BREAK SHARP; DO NOT SCALE DRAWING; REVISION; SCALE:1:1; SHEET 1 OF 1

UNLESS OTHERWISE SPECIFIED:
DIMENSIONS ARE IN MILLIMETERS
SURFACE FINISH:
TOLERANCES:
LINEAR:
ANGULAR:

NAME | SIGNATURE | DATE | | | | TITLE: DC Motor Mount

DRAWN
CHK'D
APPV'D
MFG
Q.A | | | | MATERIAL: ABS | DWG NO. | A4
