samuelwilliams413/METR4810/Submission/Mechanical/Rover/PDF/NewBody.PDF

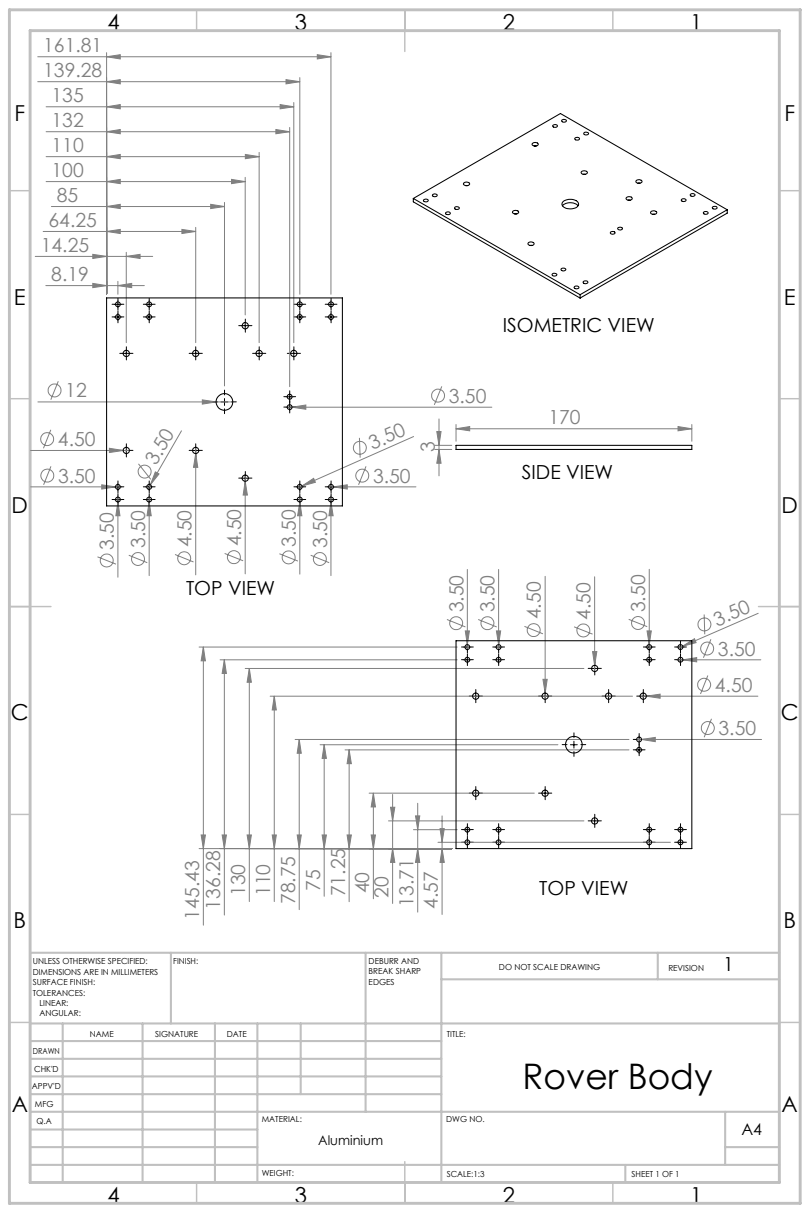
[picture p34: page 1]
SIDE VIEW; ISOMETRIC VIEW; TOP VIEW; FINISH:; DEBURR AND; BREAK SHARP; DO NOT SCALE DRAWING; REVISION; SCALE:1:3; SHEET 1 OF 1

UNLESS OTHERWISE SPECIFIED:
DIMENSIONS ARE IN MILLIMETERS
SURFACE FINISH:
TOLERANCES:
LINEAR:
ANGULAR:

NAME | SIGNATURE | DATE | | | | TITLE: Rover Body

DRAWN
CHK'D
APPV'D
MFG
Q.A | | | | MATERIAL: | DWG NO. | A4 Aluminium
