samuelwilliams413/METR4810/Submission/Mechanical/Claw/PDF/brace.pdf

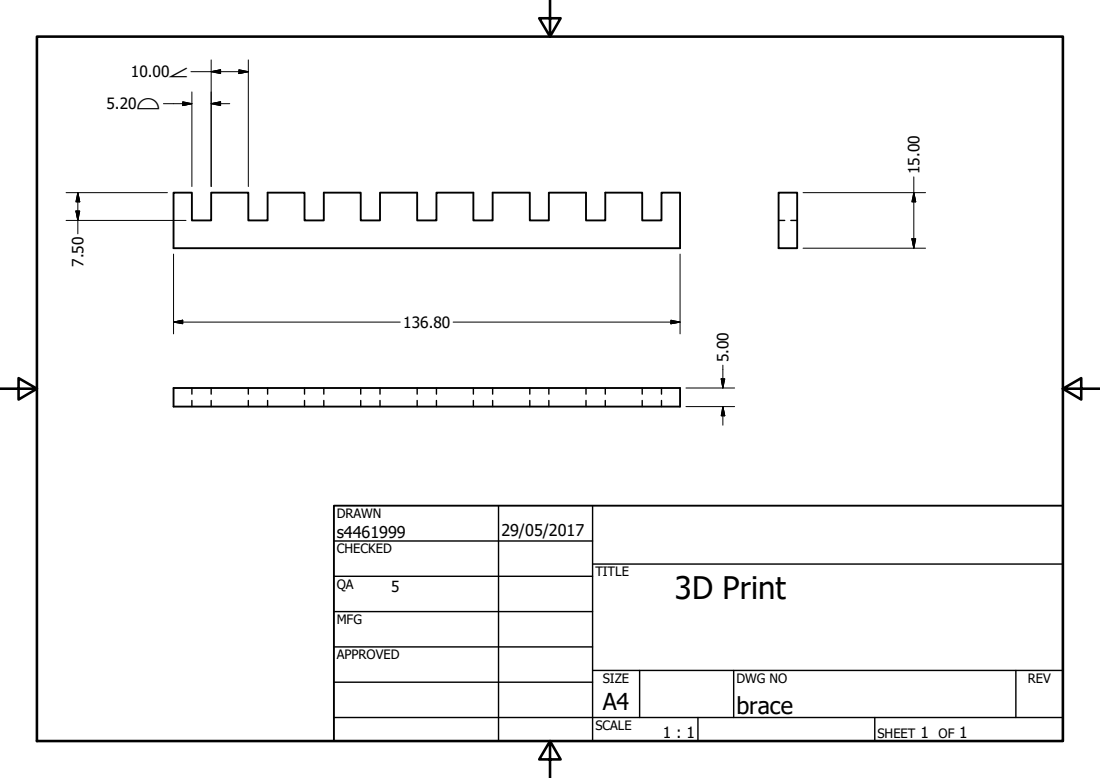
[picture p35: page 1]
SHEET 1 OF 1; DRAWN; CHECKED; MFG; APPROVED; DWG NO brace; TITLE; SIZE A4; SCALE; REV; 3D Print
