samuelwilliams413/METR4810/Submission/Mechanical/Claw/PDF/Finger.pdf

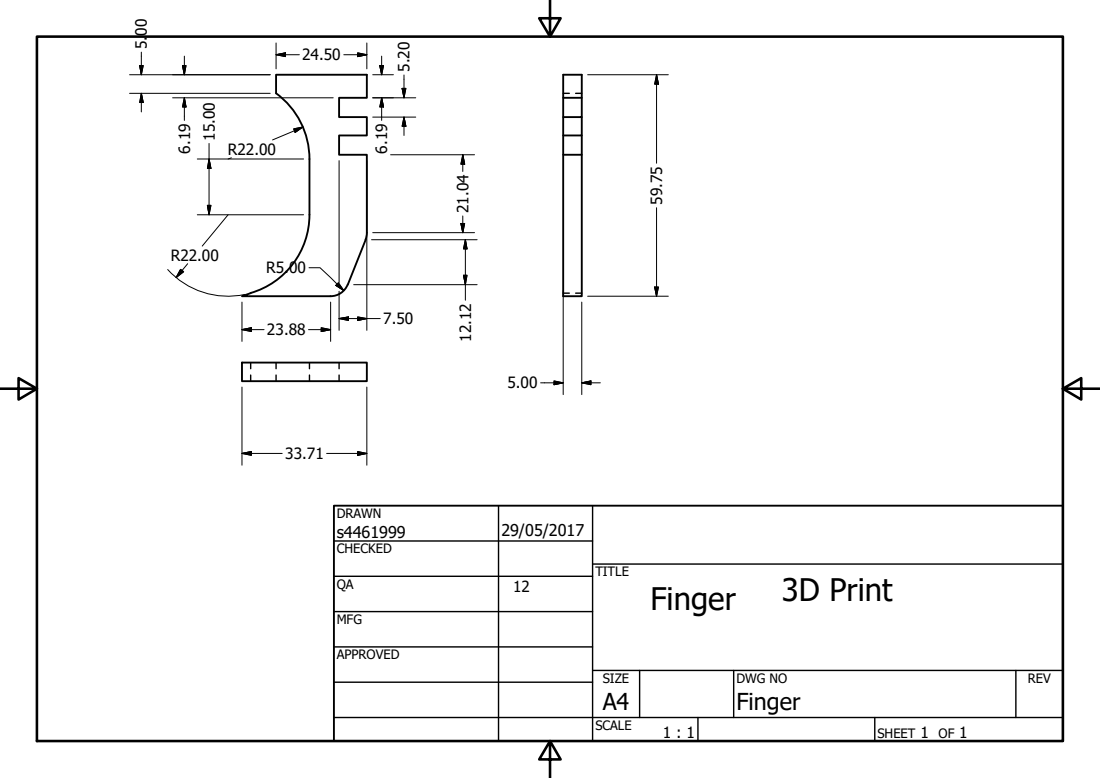
[picture p36: page 1]
SHEET 1 OF 1; DRAWN; CHECKED; MFG; APPROVED; DWG NO Finger; TITLE; SIZE A4; SCALE; REV; Finger; 3D Print
