samuelwilliams413/METR4810/Submission/Mechanical/Claw/PDF/shortBrace.pdf

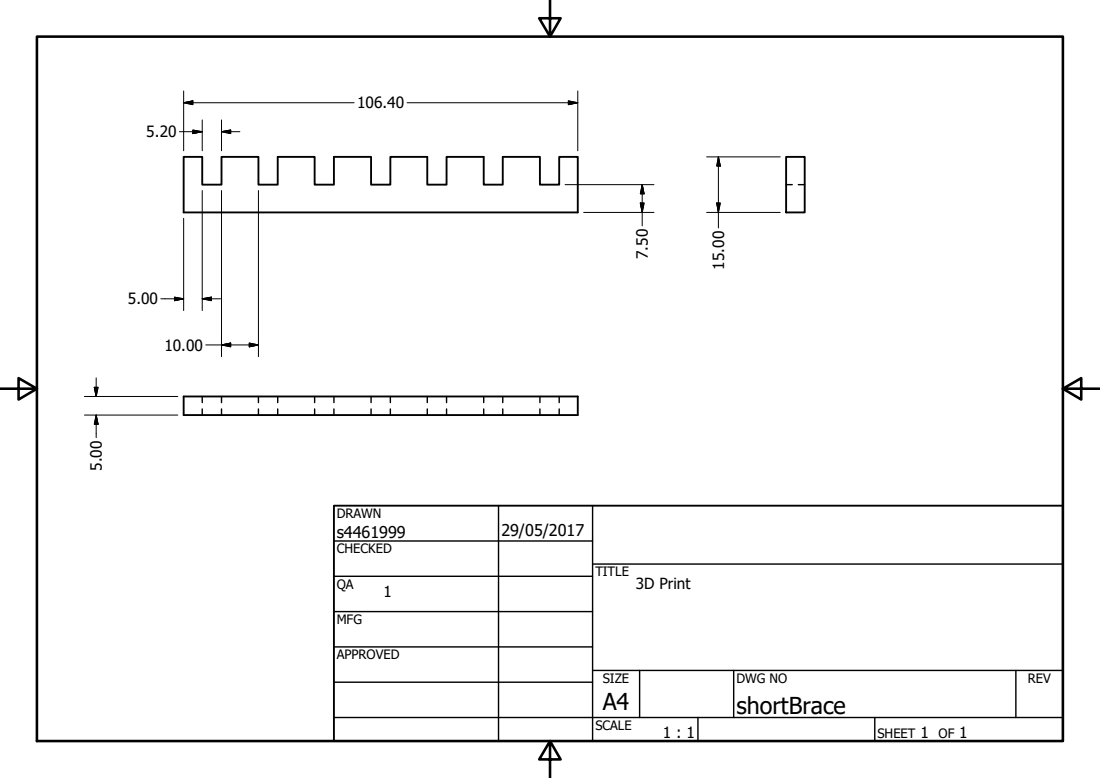
[picture p37: page 1]
SHEET 1 OF 1; DRAWN; CHECKED; MFG; APPROVED; DWG NO shortBrace; TITLE; SIZE A4; SCALE; REV; 3D Print
