samuelwilliams413/METR4810/Mechanical/ClawDesign/FirstClaw/Design/PDF_2D/arm.pdf

A

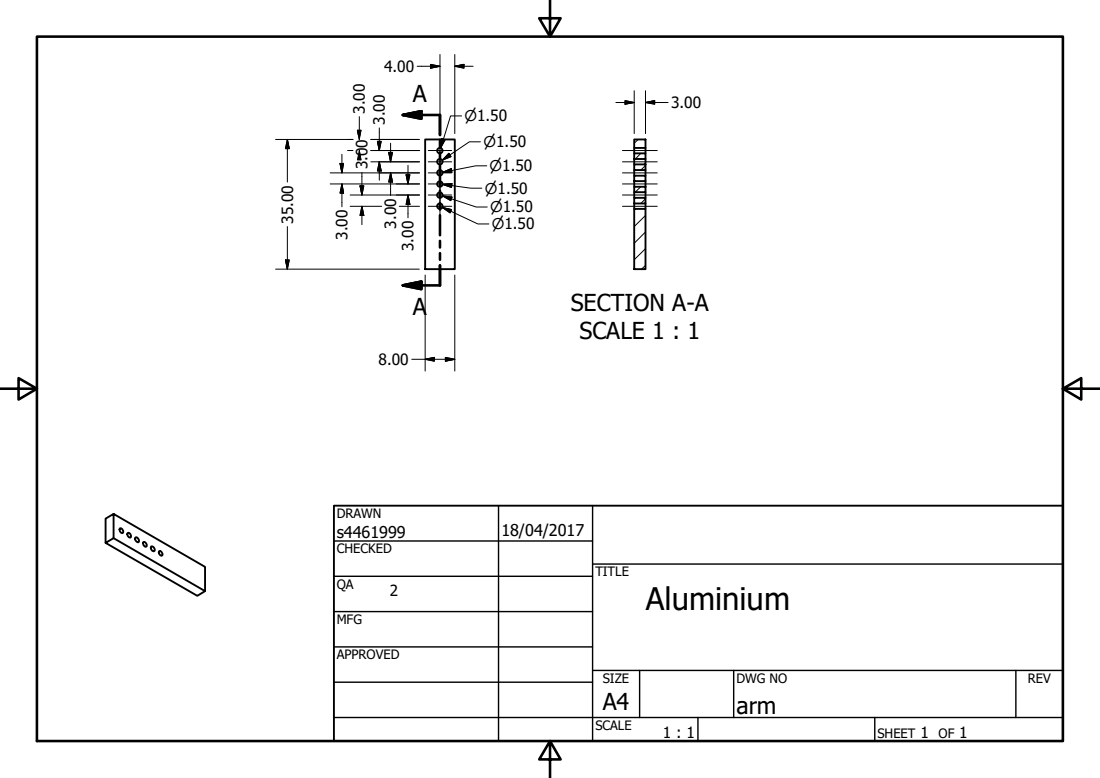
[picture p38: page 1]
SECTION A-A SCALE 1 : 1; SHEET 1 OF 1; DRAWN; CHECKED; MFG; APPROVED; DWG NO arm; TITLE; SIZE A4; SCALE; REV; Aluminium
