samuelwilliams413/METR4810/Mechanical/ClawDesign/FirstClaw/Design/PDF_2D/servoPipeConnection.pdf

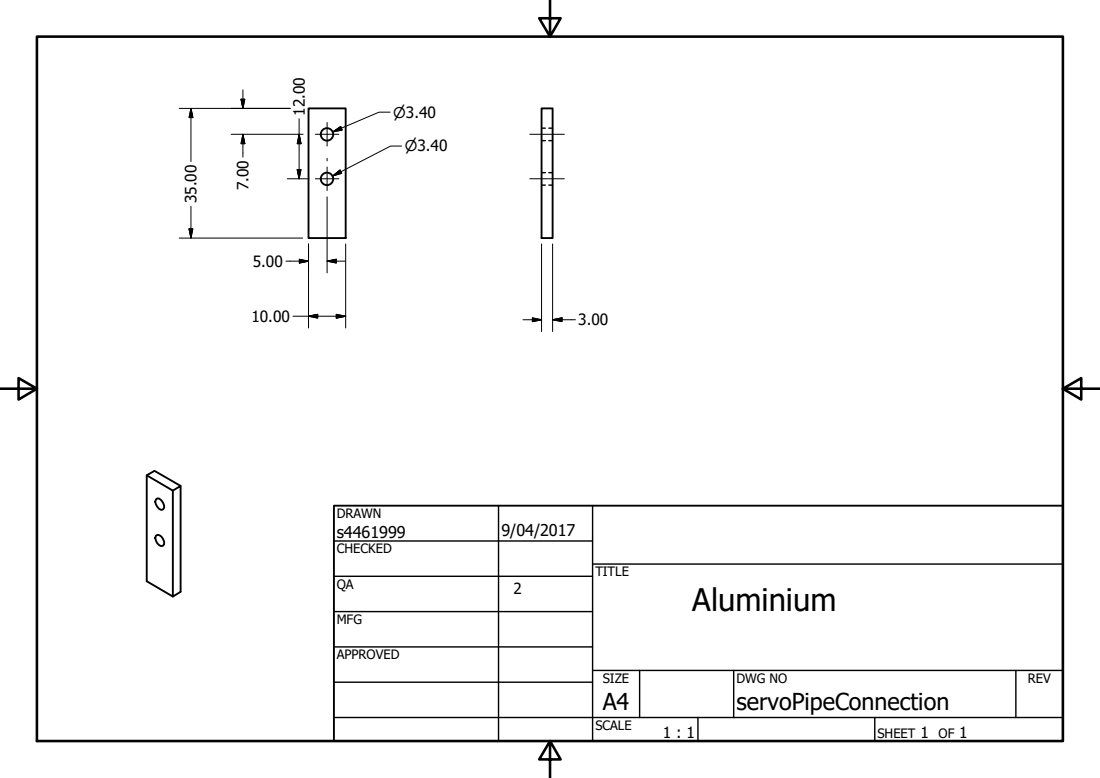
[picture p39: page 1]
SHEET 1 OF 1; DRAWN; CHECKED; MFG; APPROVED; DWG NO servoPipeConnection; TITLE; SIZE A4; SCALE; REV; Aluminium
