samuelwilliams413/METR4810/Submission/Electrical/PCB_Central_Controller/PCB_METR4810/METR4810_Schematic.pdf

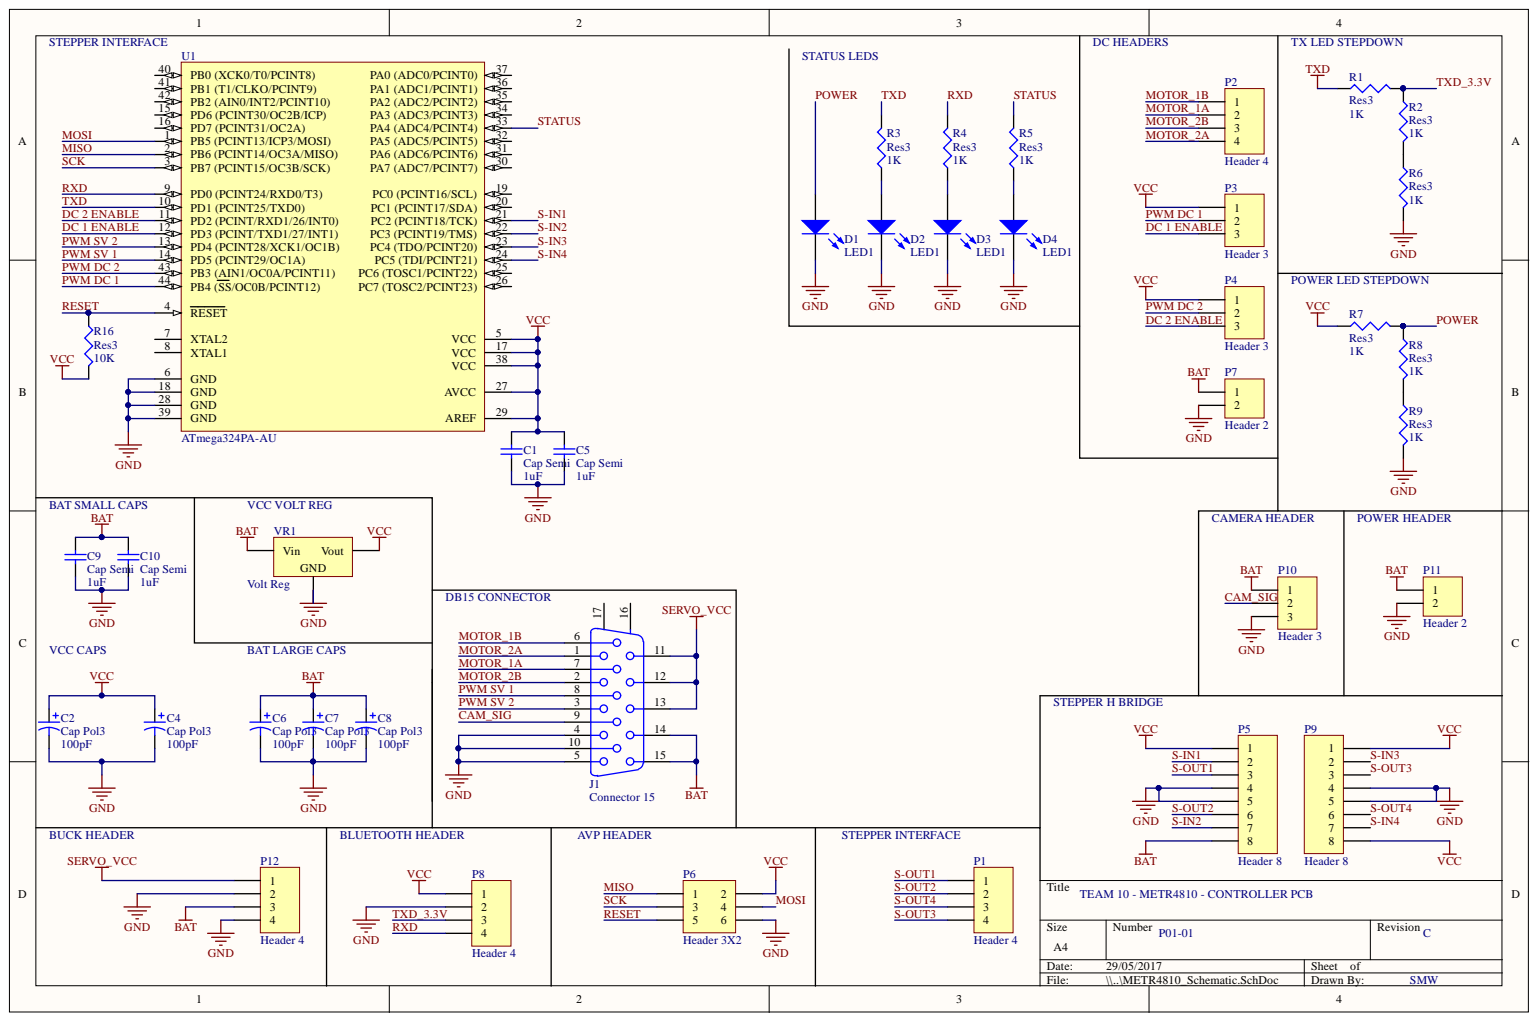
[picture p40: page 1]
