samuelwilliams413/METR4810/Submission/Electrical/PCB_Distro/Distro/Distro_schematic.pdf

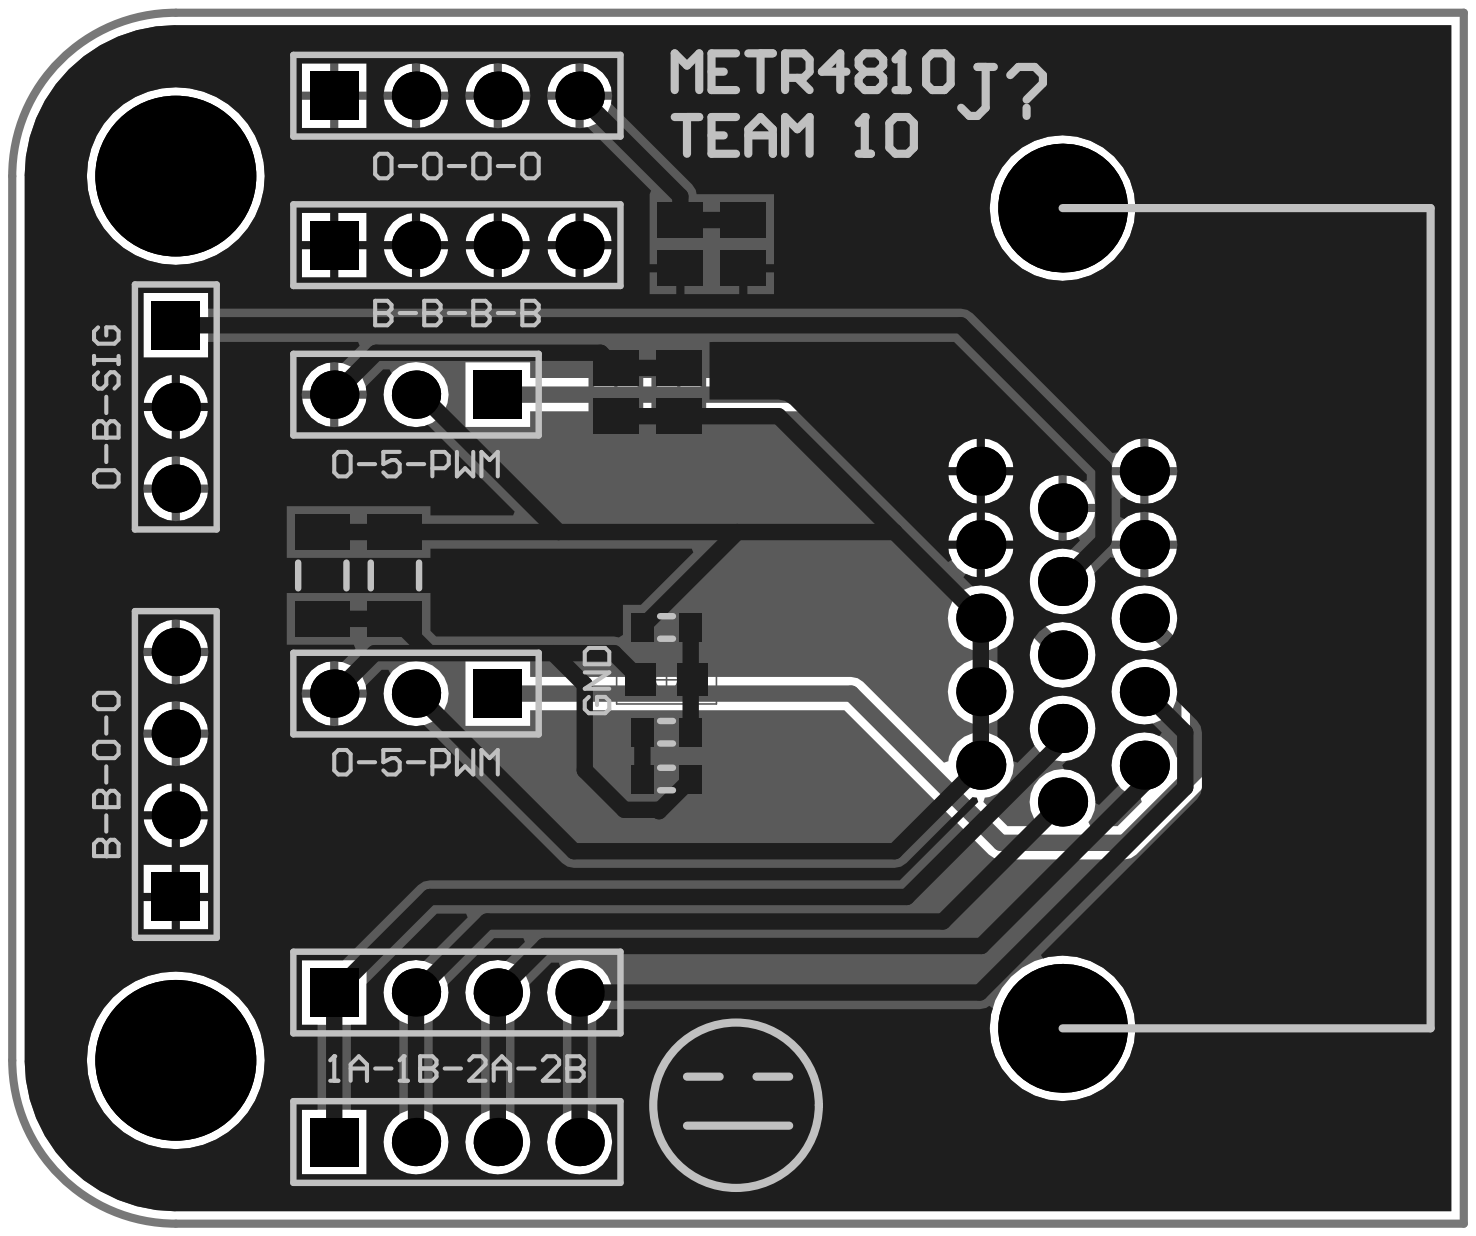
[picture p41: page 1]
