samuelwilliams413/METR4810/Mechanical/ClawDesign/ThirdClaw/Design/PDF/CenterFinger.pdf

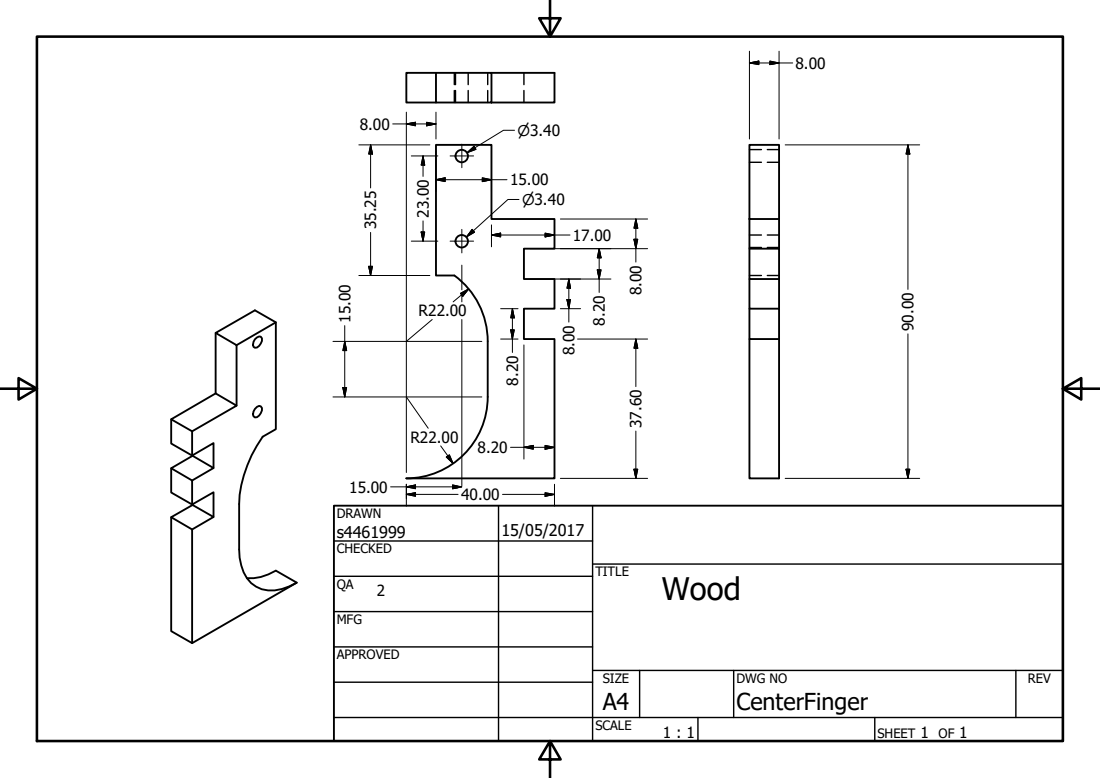
[picture p42: page 1]
SHEET 1 OF 1; DRAWN; CHECKED; MFG; APPROVED; DWG NO CenterFinger; TITLE; SIZE A4; SCALE; REV; Wood
