samuelwilliams413/METR4810/Mechanical/ClawDesign/FirstClaw/Design/PDF_2D/adjustmentHingePlate.pdf

A

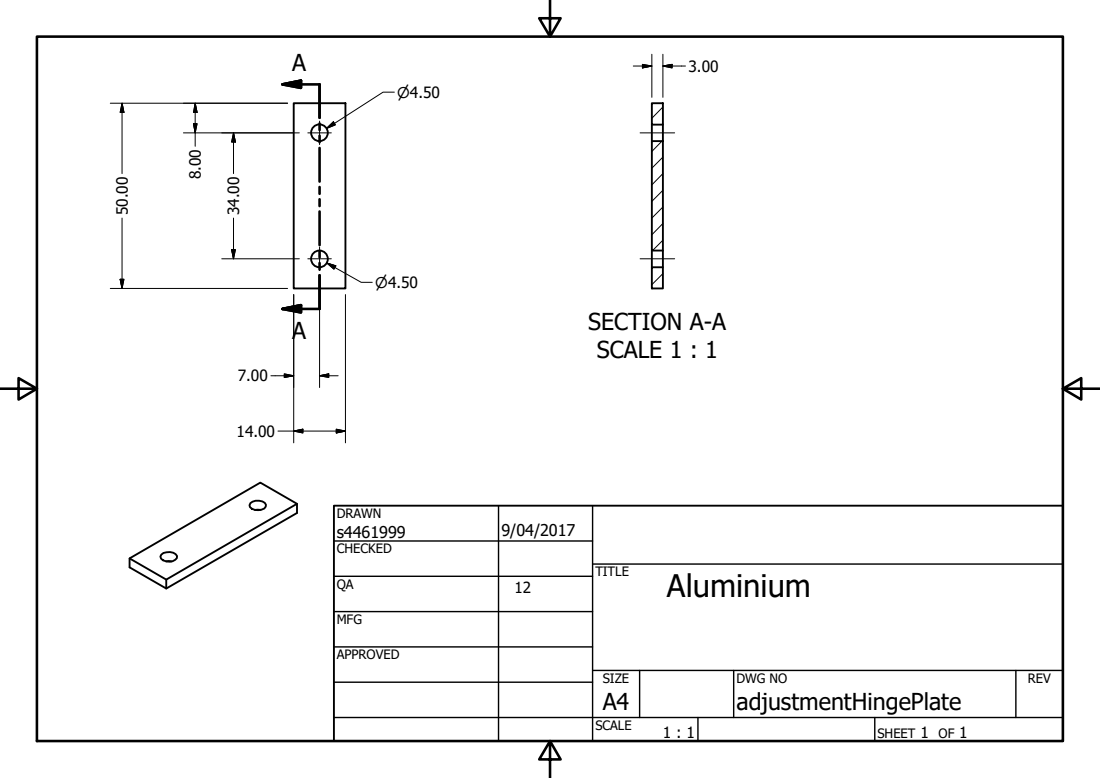
[picture p43: page 1]
SECTION A-A SCALE 1 : 1; SHEET 1 OF 1; DRAWN; CHECKED; MFG; APPROVED; DWG NO adjustmentHingePlate; TITLE; SIZE A4; SCALE; REV; Aluminium
