samuelwilliams413/METR4810/Mechanical/ClawDesign/FirstClaw/Design/PDF_2D/lowerClaw.pdf

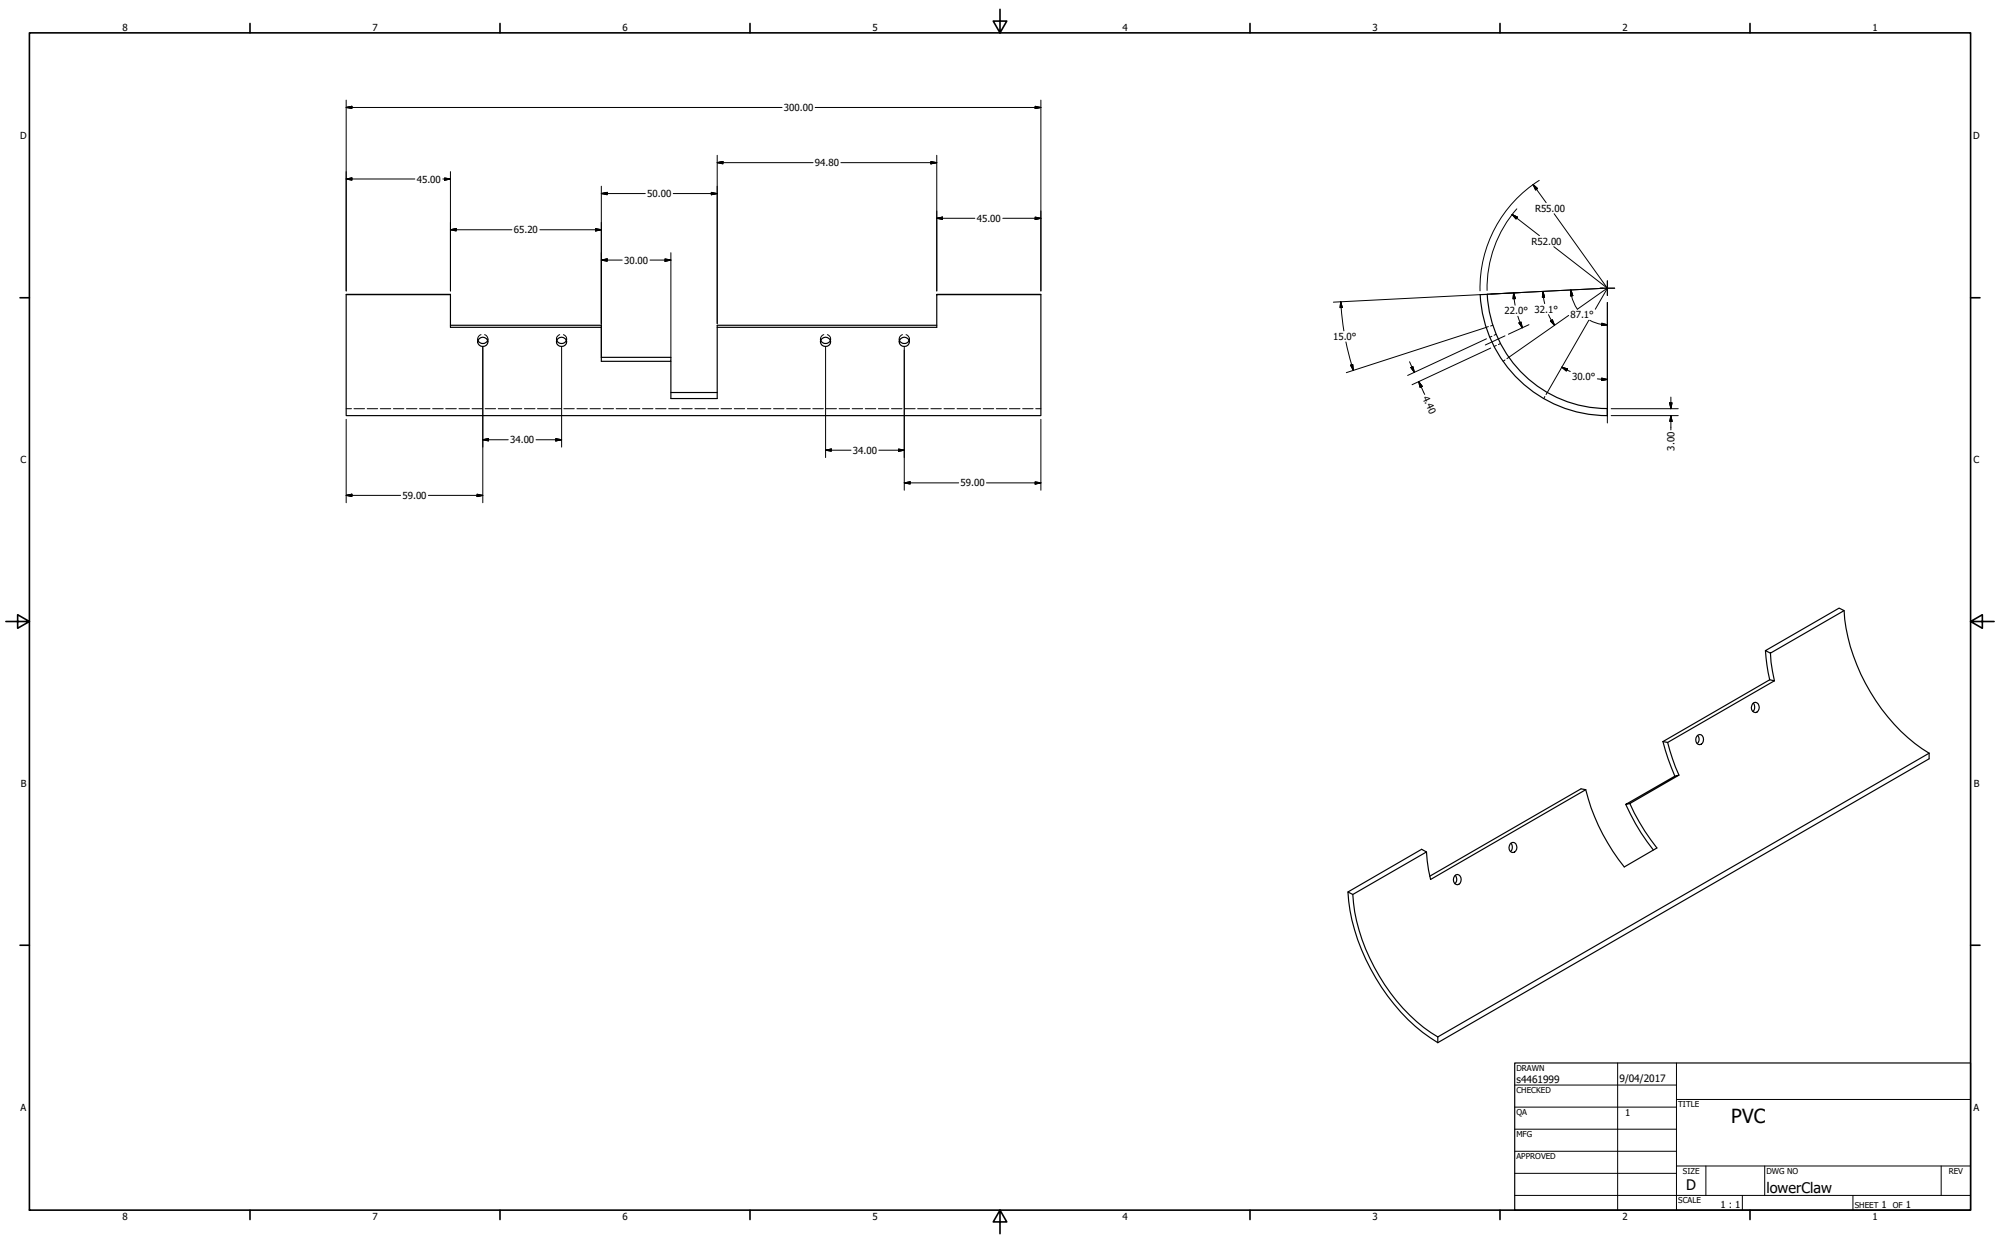
[picture p44: page 1]
SHEET 1 OF 1; DRAWN; CHECKED; MFG; APPROVED; DWG NO lowerClaw; TITLE; SIZE D; SCALE; REV; PVC
