samuelwilliams413/METR4810/Mechanical/ClawDesign/FirstClaw/Design/PDF_2D/pipeServo.pdf

A

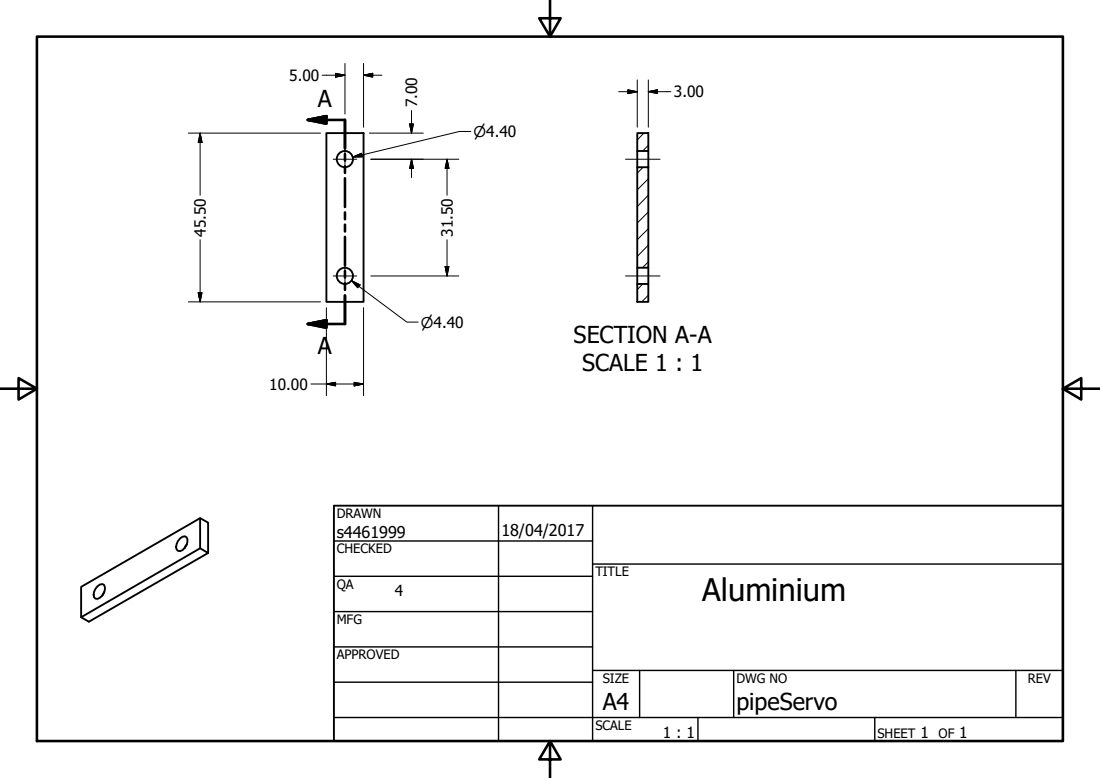
[picture p45: page 1]
SECTION A-A SCALE 1 : 1; SHEET 1 OF 1; DRAWN; CHECKED; MFG; APPROVED; DWG NO pipeServo; TITLE; SIZE A4; SCALE; REV; Aluminium
