samuelwilliams413/METR4810/Mechanical/ClawDesign/FirstClaw/Design/PDF_2D/plate.pdf

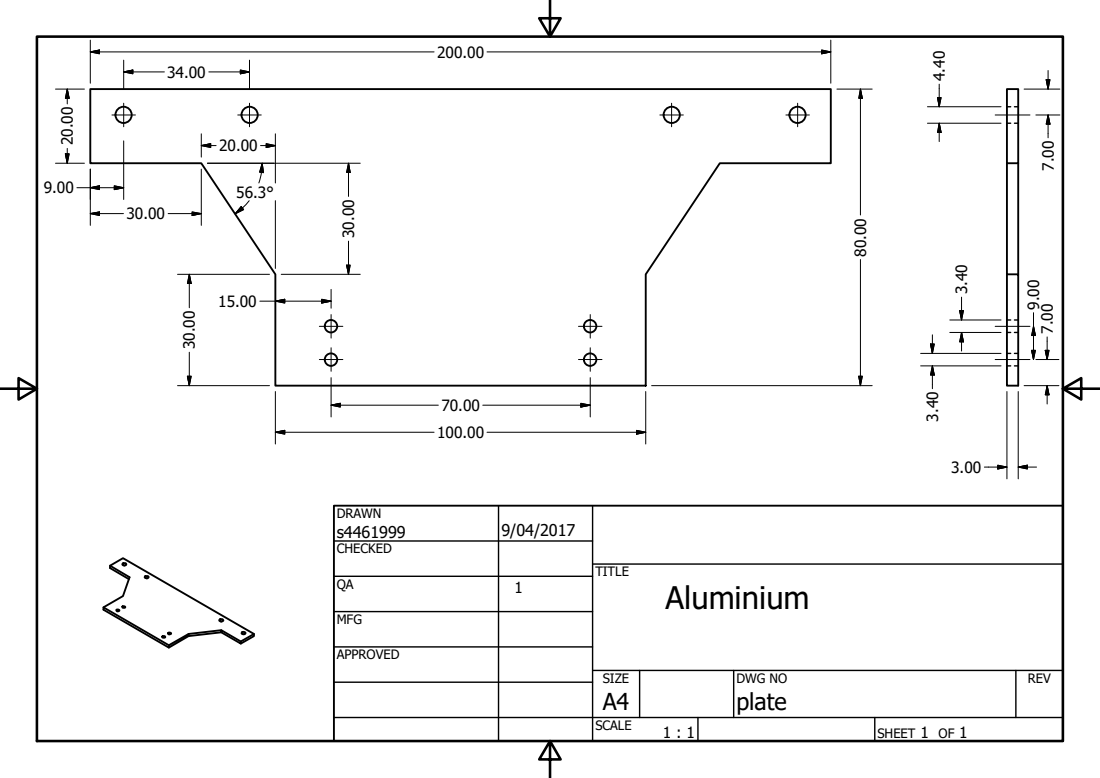
[picture p46: page 1]
pla; Alu
