samuelwilliams413/METR4810/Mechanical/ClawDesign/FirstClaw/Design/PDF_2D/upperClaw.pdf

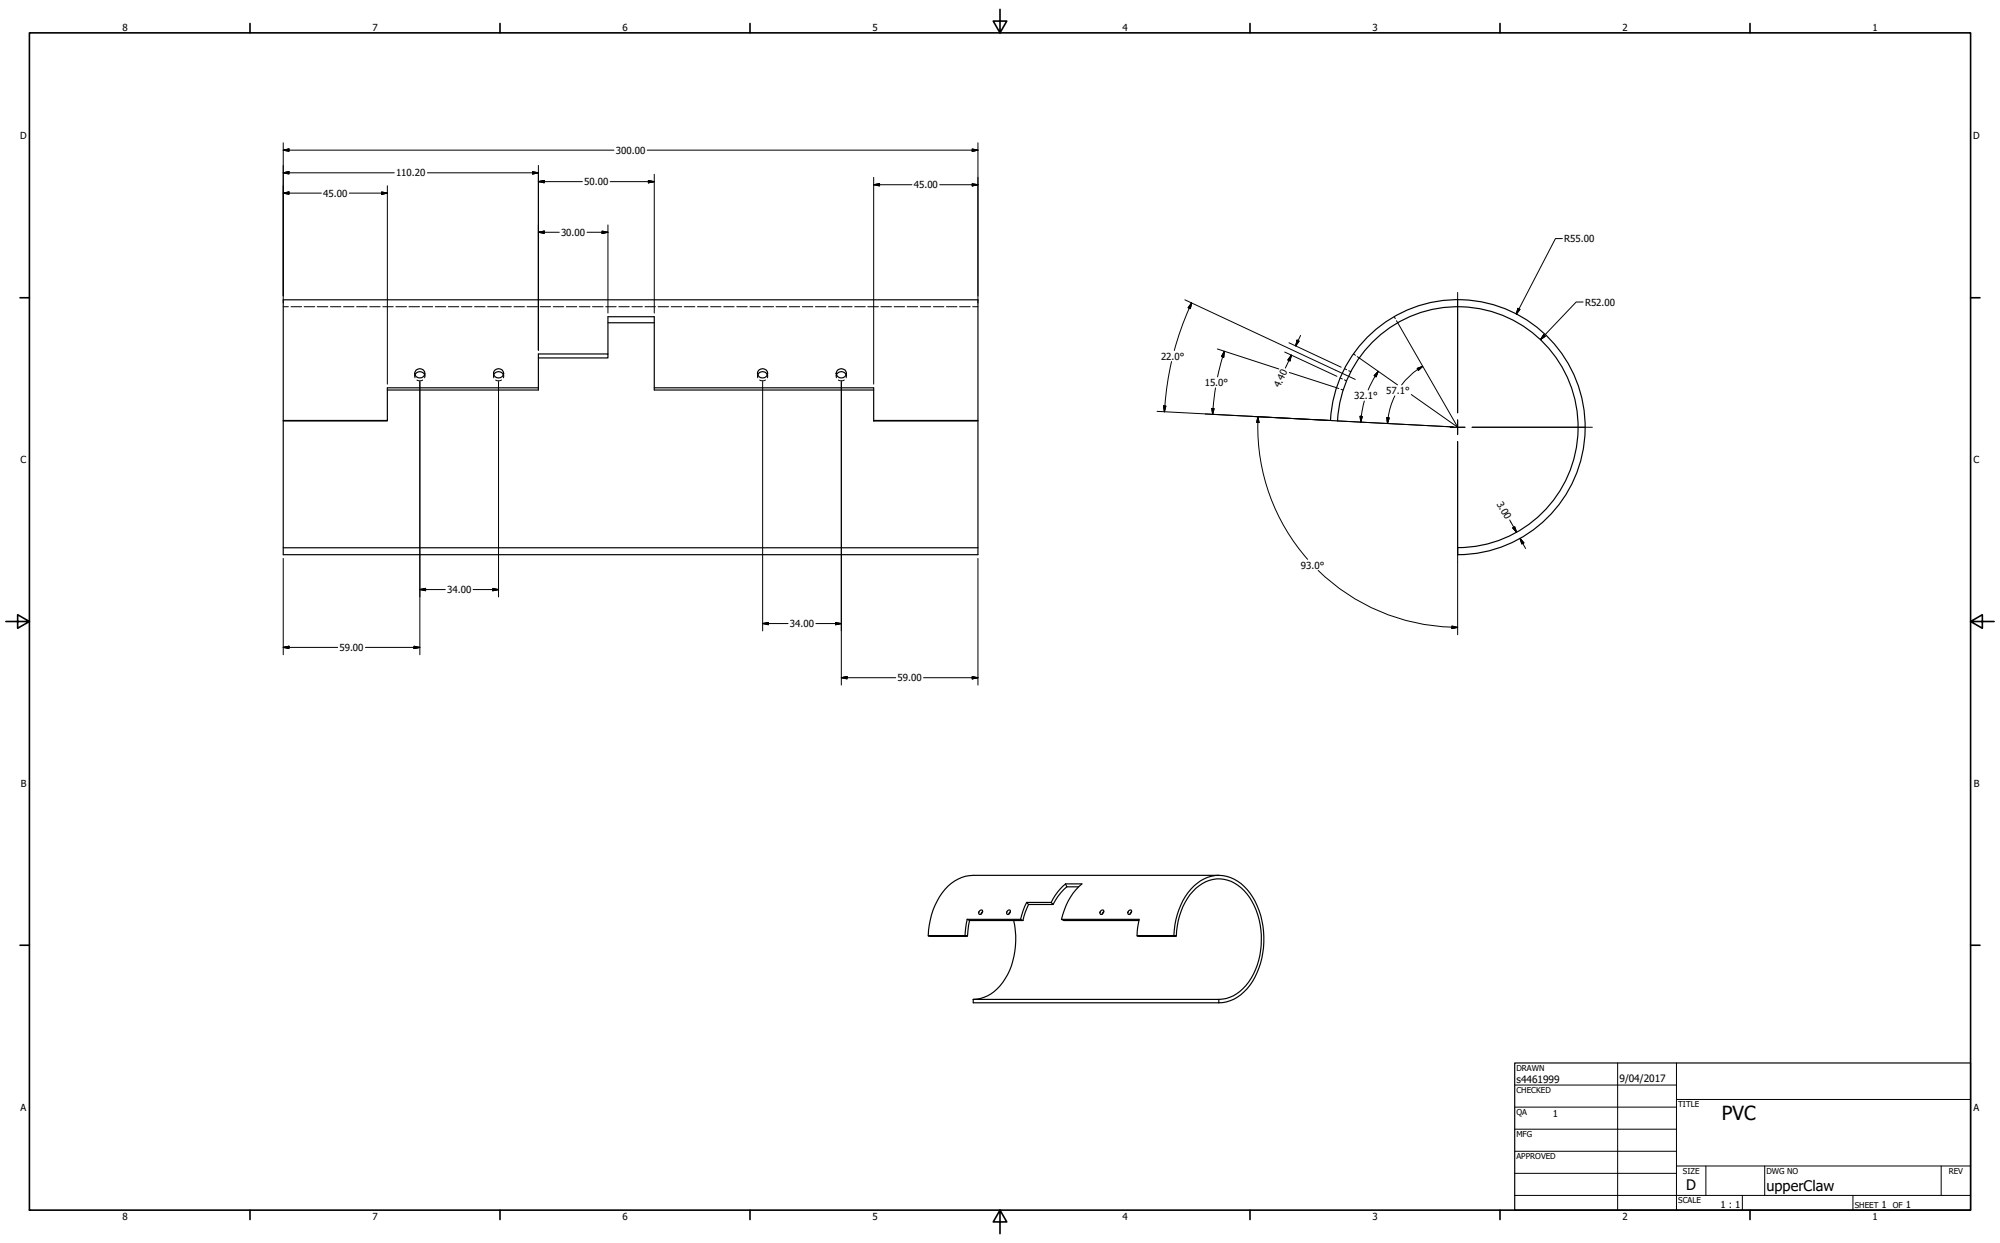
[picture p48: page 1]
SHEET 1 OF 1; DRAWN; CHECKED; MFG; APPROVED; DWG NO upperClaw; TITLE; SIZE D; SCALE; REV; PVC
