samuelwilliams413/METR4810/Electrical/PCB_Central_Controller/PCB_METR4810/METR4810_PCB_C_Layout.pdf

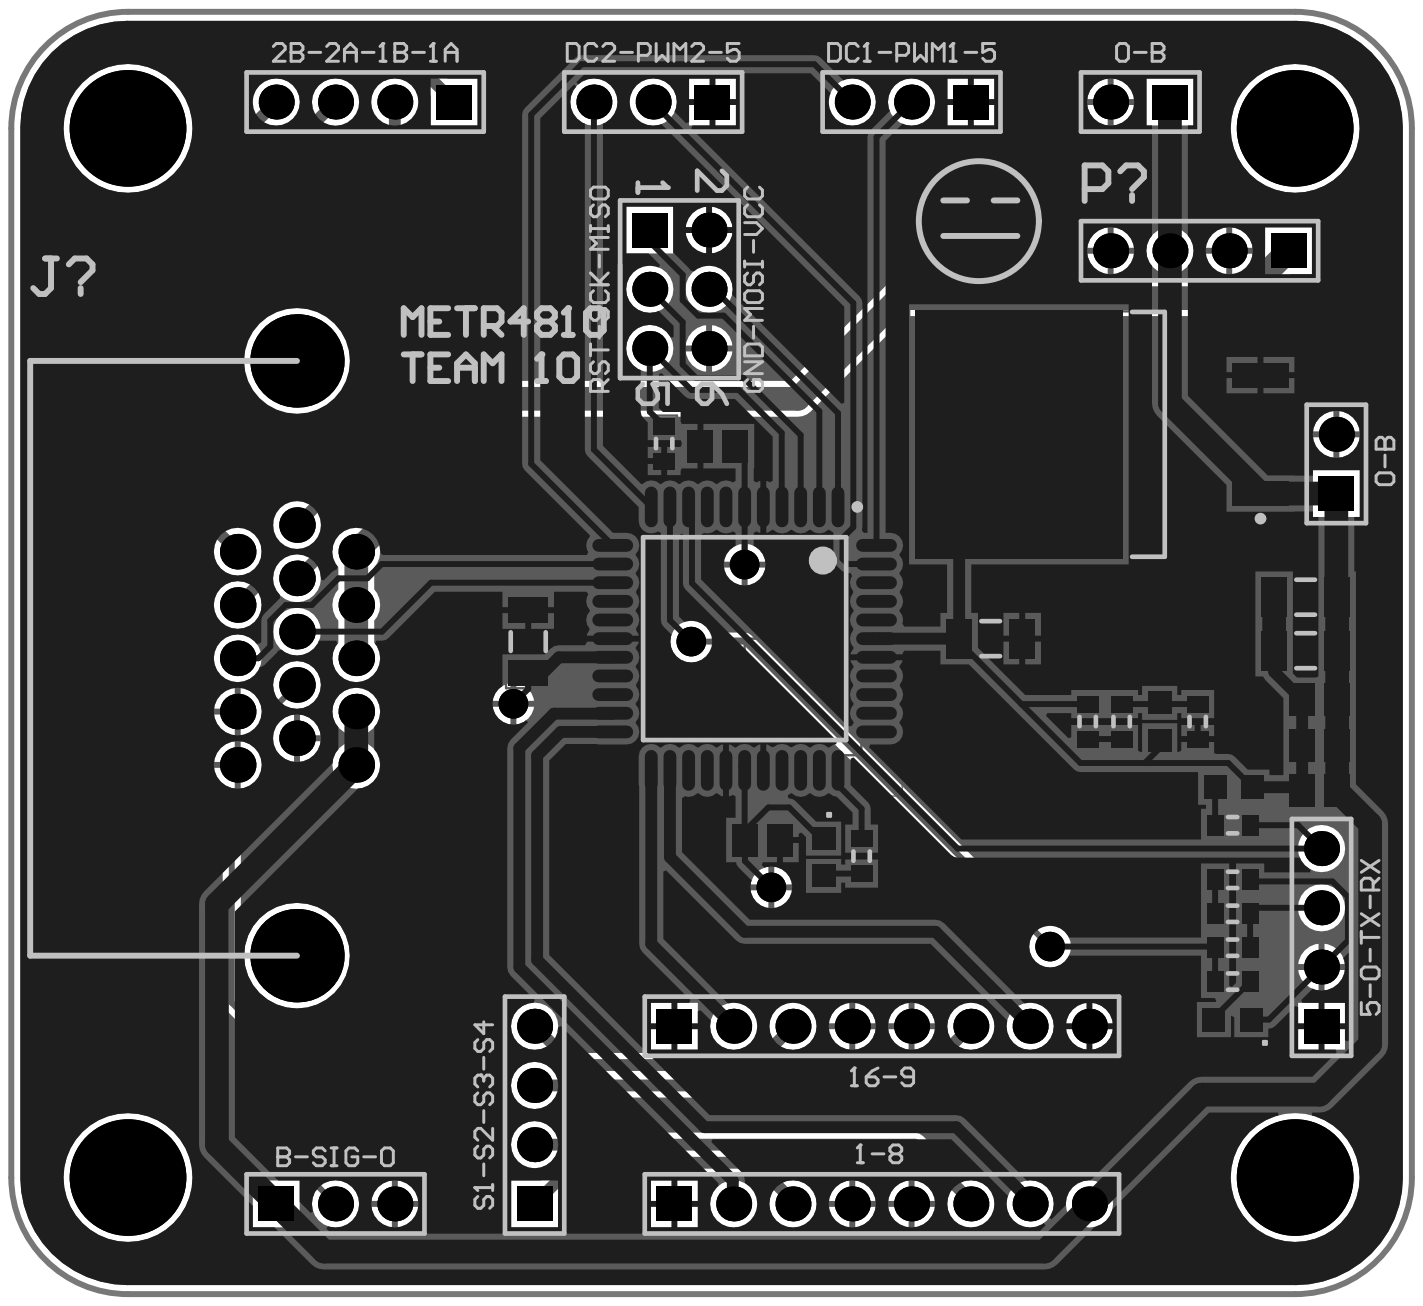
[picture p49: page 1]
