samuelwilliams413/METR4810/Submission/Electrical/PCB_Distro/Distro/Distro.pdf

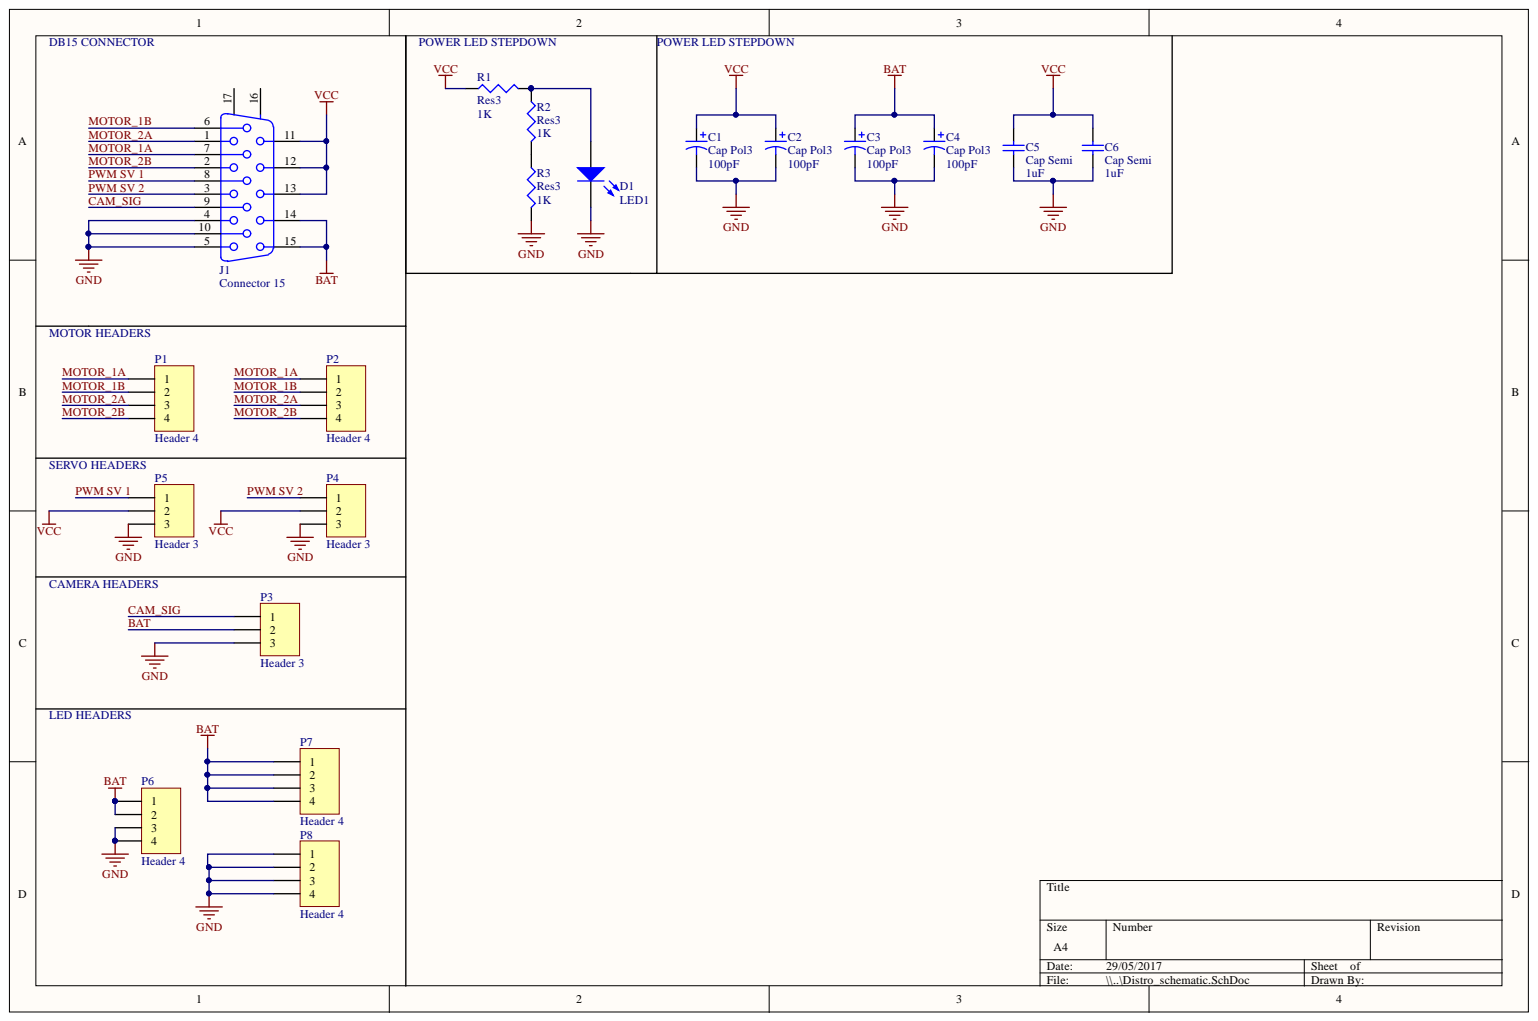
[picture p50: page 1]

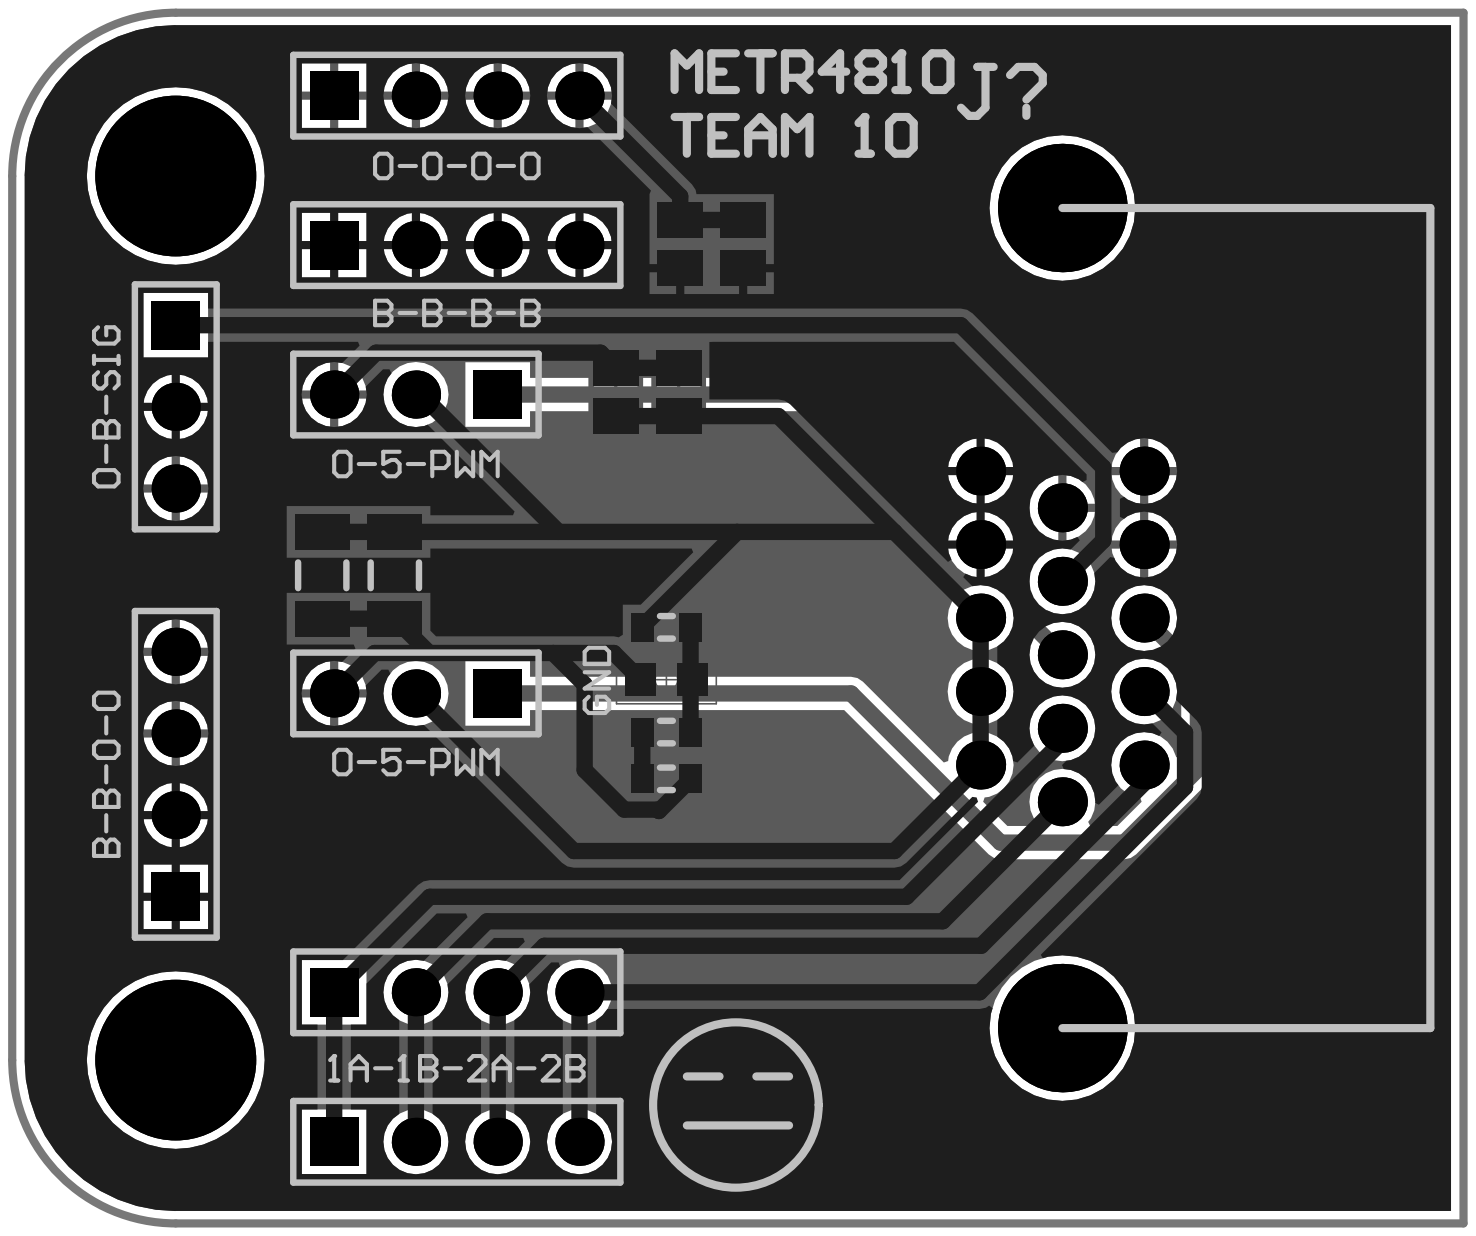
[picture p51: page 2]
