samuelwilliams413/METR4810/(list of files, drawings)

Other design files:
Electrical/PCB_Breakout_324/PCB_Project/PCB_Project.PrjPcb
Electrical/PCB_Central_Controller/PCB_METR4810/METR4810_PCB_C_Layout.PcbDoc
Electrical/PCB_Central_Controller/PCB_METR4810/METR4810_Schematic.SchDoc
Electrical/PCB_Central_Controller/PCB_METR4810/Octopart-CPL.PcbLib
Electrical/PCB_Central_Controller/PCB_METR4810/PCB_METR4810.PrjPcb
Electrical/PCB_Central_Controller/PCB_METR4810/PcbLib1.PcbLib
Electrical/PCB_Central_Controller/PCB_METR4810/VGA_F.PcbLib
Electrical/PCB_Central_Controller/PCB_METR4810/VGA_M.PcbLib
Electrical/PCB_Distro/Distro/Distro.PrjPcb
Submission/Electrical/PCB_Central_Controller/PCB_METR4810/METR4810_PCB_C_Layout.PcbDoc
Submission/Electrical/PCB_Central_Controller/PCB_METR4810/METR4810_Schematic.SchDoc
Submission/Electrical/PCB_Central_Controller/PCB_METR4810/Octopart-CPL.PcbLib
Submission/Electrical/PCB_Central_Controller/PCB_METR4810/PCB_METR4810.PrjPcb
Submission/Electrical/PCB_Central_Controller/PCB_METR4810/VGA_F.PcbLib
Submission/Electrical/PCB_Central_Controller/PCB_METR4810/VGA_M.PcbLib
Submission/Electrical/PCB_Distro/Distro/Distro.PrjPcb
Submission/Electrical/PCB_Distro/Distro/Distro_layout_top_buck.PcbDoc
Submission/Electrical/PCB_Distro/Distro/Distro_schematic.SchDoc
Submission/Electrical/PCB_Distro/Distro/Octopart-CPL.PcbLib
Submission/Electrical/PCB_Distro/Distro/VGA_F.PcbLib
Submission/Electrical/PCB_Distro/Distro/VGA_M.PcbLib
