samuelwilliams413/METR4810/(commit log)

2017-03-15 PCB Schematic Uploaded
    -Layout to be completed
    -Remember to add testing pads
    [PCB_Project1.PrjPCB, Sheet1.SchDoc]
2017-03-15 PCB - Rearranging pin allocation
    -Attempting to simplify circuits
    [PCB1.PcbDoc, PCB_Project1.PrjPCB, Sheet1.SchDoc, WillsFootPrintLibrary.PcbLib, WillsSchematicLibrary.SchLib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]
2017-03-15 PCB - Reallocation Complete
    [PCB1.PcbDoc, PCB_Project1.PrjPCB, Sheet1.SchDoc]
2017-03-16 PCB - Arranged
    [PCB1.PcbDoc, Sheet1.SchDoc]
2017-03-16 PCB - Routing is taking forever
    [PCB1.PcbDoc, Sheet1.SchDoc]
2017-03-17 Machined Component - Rough Sketch Completed
    Exact dimensions TBC
    [Stepper_Key.0001.dwg, Stepper_Key.dwg, Stepper_Key.ipt]
2017-03-17 PCB - Going to try new orientations
    [PCB1.PcbDoc, Sheet1.SchDoc]
2017-03-17 PCB - There are two pin 17
    [Sheet1.SchDoc]
2017-03-17 PCB - Starting board again
    [PCB1.PcbDoc]
2017-03-17 PCB - Its not shit
    [PCB1.PcbDoc]
2017-03-18 PCB - Looking swish
    [PCB1.PcbDoc, Sheet1.SchDoc]
2017-03-22 PCB - Design rule violations sorted
    [PCB1.PcbDoc]
2017-03-22 Bluetooth working / PCB ordered
    [PCB1.PcbDoc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]
2017-03-23 Sam forgot to commit
    [BOM_Sam.xlsx]
2017-03-25 PCB - Breakout Rev A
    [32M1bREAKOUT.PrjPcb, PCB1.PcbDoc, PCB2.PcbDoc, PCB_Project1.PrjPCB, Sheet2.SchDoc, Sheet3.SchDoc, WillsFootPrintLibrary.PcbLib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]
2017-03-25 Organised File Tree
    [32M1bREAKOUT.PrjPcb, BOM_Sam.xlsx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]
2017-04-02 pcb 2 started
    [32M1bREAKOUT.PrjPcb, 4810_PCB.PrjPcb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]
2017-04-04 PCB 2 Organising schematic
    [4810_PCB.PrjPcb, PCB_Layout.PcbDoc]
2017-04-05 Second PCB Completed
    [METR4810_PCBLayout.PcbDoc, METR4810_Schematic.SchDoc, PCB_METR4810.PrjPcb, WillsFootPrintLibrary.PcbLib, WillsSchematicLibrary.SchLib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]
2017-04-06 pcb REV b
    [METR4810_PCBLayout.GBL, METR4810_PCBLayout.GBP, METR4810_PCBLayout.GBS, METR4810_PCBLayout.GKO, METR4810_PCBLayout.GTL, METR4810_PCBLayout.GTO, METR4810_PCBLayout.GTP, METR4810_PCBLayout.GTS]
2017-04-11 Comms Ported Converting Code
    [7April_PCB.GBL, 7April_PCB.GBP, 7April_PCB.GBS, 7April_PCB.GKO, 7April_PCB.GTL, 7April_PCB.GTO, 7April_PCB.GTP, 7April_PCB.GTS]
2017-04-11 Updated Bill of Materials
    -Also mucked about with fuses
    [BOM_Sam.xlsx]
2017-04-12 Bill of Materials Sam
2017-04-12 Added mohamed's BOM
2017-04-15 Interrupt based comms implemented
2017-04-16 Updated PCB Documents
    Most recent schematic @
    METR4810\Electrical\PCB_Revision B\PCB_METR4810\METR4810_Schematic.pdf
    [7April_PCB.PcbDoc, METR4810_PCBLayout.PcbDoc, METR4810_Schematic.SchDoc, PCB_METR4810.PrjPcb, WORKS_PCB.PcbDoc]
2017-04-17 Added Data Sheets for PCB
2017-04-17 Updated BOM and Parts List for PCB rev B
    Found @
    METR4810\Bill of Materials\Sam_BOM_Part List.xlsx
    [BOM_Sam.xlsx, Sam_BOM_Part List.xlsx]
2017-04-20 pcb - Changed PWM pins
    [METR4810_PCBLayout.PcbDoc, METR4810_Schematic.SchDoc, PCB_METR4810.PrjPcb]
2017-04-20 PCB - Implimented Andres Pinout
    [METR4810_PCBLayout.PcbDoc, METR4810_Schematic.SchDoc]
2017-04-23 cable management
    [Breakout_layout.PcbDoc, Breakout_schematic.SchDoc, Distro.PrjPcb, Distro_layout.PcbDoc, Distro_schematic.SchDoc, PCB_Project.PrjPcb]
2017-04-23 Main PCB rev C done
    [METR4810_PCBLayout.PcbDoc, METR4810_PCB_b_Layout.PcbDoc, METR4810_Schematic.SchDoc, PCB_METR4810.PrjPcb]
2017-04-23 Disto board completed
    [Distro.PrjPcb, Distro_layout.PcbDoc, Distro_schematic.SchDoc, METR4810_PCB_b_Layout.PcbDoc, METR4810_Schematic.SchDoc, WillsFootPrintLibrary.PcbLib, WillsSchematicLibrary.SchLib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]
2017-04-23 breakout started, i gave up
    [Breakout_layout.PcbDoc, Breakout_schematic.SchDoc, Distro.PrjPcb, Distro_layout.PcbDoc, PCB_Project.PrjPcb]
2017-04-24 Breakout completed, Slip ring Datasheet added
    [Breakout_layout.PcbDoc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]
2017-04-24 Added claw design and calculations (old version)
    [ABA 01.ipt, ABA 01.stp, ABA 02.stp, CLAW.iam, CLAW.stp, HINGE SUS-304.ipt, HINGE SUS-304.stp, PINO SUS-304.stp]
2017-04-28 Added Claw Idea
2017-04-29 Added Slip Ring Mount
2017-04-30 Added files for spool printing
    [2xSpoolMount.stl, Assembly1-1.0001.dwg, Assembly1-1.dwg, Assembly1.0002.iam, Assembly1.iam, SlipRing-022A-12.ipt, Slipring_mount.0001.ipt, Slipring_mount.0002.ipt]
2017-04-30 toPrint Updated
    [Spool_revB1.0003.ipt, Spool_revB1.ipt, Spool_revB2.0003.ipt, Spool_revB2.ipt, Spool_revB2.stl, Spool_revB3.0004.ipt, Spool_revB3.ipt, Spool_revB3.stl]
2017-05-03 Both codes for timer1 servo and timer2 servo
2017-05-08 Code for the 75 demo without timers
2017-05-09 Starting PCBs
    [Distro.PrjPcb, Distro_schematic.SchDoc, METR4810_PCB_C_Layout.PcbDoc, METR4810_Schematic.SchDoc, PCB_METR4810.PrjPcb]
2017-05-10 Distro Rev B
    [Distro.PrjPcb, Distro_layout_B.PcbDoc, Distro_schematic.SchDoc, METR4810_PCB_C_Layout.PcbDoc, METR4810_Schematic.SchDoc, PCB_METR4810.PrjPcb, PcbLib1.PcbLib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]
2017-05-10 PCB Main Rev C
    [Distro.PrjPcb, Distro_layout_B.PcbDoc, Distro_schematic.SchDoc, METR4810_PCB_C_Layout.PcbDoc, METR4810_Schematic.SchDoc, PCB_METR4810.PrjPcb]
2017-05-10 PCBs Updated for DB9 and Buck Converter
    [Distro.PrjPcb, Distro_layout_B.PcbDoc, Distro_schematic.SchDoc, METR4810_PCB_C_Layout.PcbDoc, METR4810_Schematic.SchDoc, PCB_METR4810.PrjPcb]
2017-05-10 Added End Spool
    [Spool_end_piece.stl, Spool_revB2.0002.ipt, Spool_revB2.0003.ipt, Spool_revB2.0004.ipt, Spool_revB2.ipt, Spool_revB3.0005.ipt]
2017-05-10 Adding PCB Changes
    [2xSpoolMount.stl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]
2017-05-10 More Changes
    [32M1bREAKOUT.PrjPcb, 4810_PCB.PrjPcb, BillOfMaterials.xlsx, Breakout_layout.PcbDoc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]
2017-05-10 Buck Relocated
    [Distro.PrjPcb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]
2017-05-12 Cleaned up Electrical Repo and added schematics
    [Distro.PrjPcb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]
2017-05-12 Bill of Materials Updated
    [Sam_BOM_Part List.xlsx]
2017-05-14 Second claw
    [ABA 01.ipt, ABA 01.stp, ABA 02.stp, Assembly.iam, CLAW.iam, CLAW.stp, CenterFinger.0003.ipt, CenterFinger.ipt]
2017-05-14 stepper interupt code
    [32M1bREAKOUT.PrjPcb, 4810_PCB.PrjPcb, BillOfMaterials.xlsx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]
2017-05-14 Added interupt based stepper code (TC2)
    [2xSpoolMount.stl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]
2017-05-15 Draft of final budget
    [Budget final.xlsx]
2017-05-16 Third claw and software working with servos
    [CenterFinger.0005.ipt, CenterFinger.dwg, CenterFinger.ipt, Finger.0006.ipt, Finger.dwg, Finger.ipt, brace.0001.dwg, brace.0001.ipt]
2017-05-17 Stepper Update
    Added hold and relax functions to stepper
    Made stepper backwards hold position
    Added stepper and rover state to system status
2017-05-21 Claw to print
    [Finger.ipt, Finger.stl, brace.ipt, brace.stl]
2017-05-25 gear and middle blades attached
    [gearfinger1.ipt, gearfinger2.iam, gearfinger2.stl]
2017-05-27 Camera movement changes
2017-05-27 Short brace to print
    [shortBrace.0003.ipt, shortBrace.ipt, shortBrace.stl]
2017-05-28 Adding BOM and datasheets
    [Sam_BOM_Part List.xlsx]
2017-05-28 2D Drawings
    [Finger.0001.dwg, Finger.dwg, brace.0001.dwg, brace.dwg, shortBrace.dwg]
2017-05-28 Submission folder
    [7April_PCB.GBL, 7April_PCB.GBP, 7April_PCB.GBS, 7April_PCB.GKO, 7April_PCB.GTL, 7April_PCB.GTO, 7April_PCB.GTP, 7April_PCB.GTS]
2018-05-02 18 Days
    [Distro.PrjPcb, PCB_METR4810.PrjPcb]
